OpenLightingProject/ja-rule/boardcfg/README.md

The sub-directories contain the software configuration for each of the
different hardware devices.

The software configuration specifies:
 - which I/O pins to use
 - USB properties, like power consumption
 - Memory organization (for the bootloader).
