OpenLightingProject/ja-rule/hardware/number1/README.md

The hardware design for the Number1 board.
