OpenLightingProject/ja-rule/doxygen/images/transceiver.png

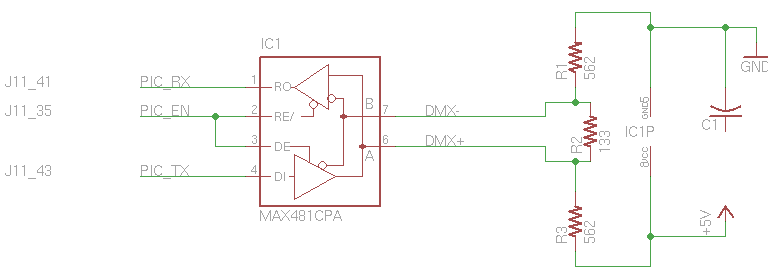
doxygen/images/transceiver.png
