OpenLightingProject/ja-rule/user_manual/README.md

To generate the documentation run

`doxygen`

in this directory. The generated files will be in the *output* directory.
