OpenLightingProject/ja-rule/user_manual/gen/README.md

To re-generate the files in this directory run

$ make doc-gen

from the root ja-rule directory.
