OpenLightingProject/ja-rule/user_manual/docs/examples.md

Examples (remove when complete)
================

[TOC]

# Section 1  {#section1}

First part of updating

## Section 1a  {#section1a}

> Block quote
> Another block quot

# Section 2 {#section2}

1. One
2. Two

# Section 3

This is a *markdown* **file**

 - list one
 - list two

# Section 4

[github]: http://www.example.com "Github"

Code

    this is a block of code
    cont.

end code

`a code span`

# Section 5

---

[github]

# Section 6

First Header  | Second Header
------------- | -------------
Content Cell  | Content Cell
Content Cell  | Content Cell

# Section 7

[back to section 1] (#section1)

# Section 8

I get 10 times more traffic from [Google] than from
[Yahoo] or [MSN].

[google]: http://google.com/        "Google"
[yahoo]:  http://search.yahoo.com/  "Yahoo Search"
[msn]:    http://search.msn.com/    "MSN Search"
