OpenLightingProject/ja-rule/user_manual/images/mac-usb.png

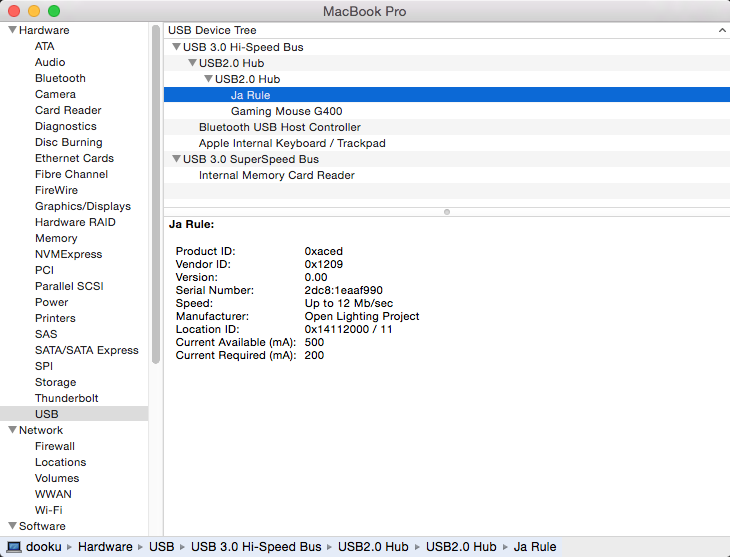
user_manual/images/mac-usb.png
