OpenLightingProject/ja-rule/tests/README.md

# Testing

This directory contains the tests & test infrastructure for the Ja Rule
platform. We use gmock / gtest.

## Directory Layout

**harmony**, The stubbed out harmony API. We stub / mock out all the harmony
calls we make so that we don't have to pull in harmony when running the tests.

**mocks**, The mocks for each module which are used for dependency injection.

**sim**, A basic PIC32 simulator.

**system_config**, The system config header files, including system_config.h &
system_definitions.h

**tests**, The unit tests.
