OpenLightingProject/ja-rule/(threads)

Thread 23 (2015-03-06):

Reset USB CDC transfers when the carrier disconnects

nomis52, 2015-03-06:
Right now, if you have a console  (minicom) open to the device and disconnect the CDC layer is left in a partially completed state.  This means if you later reconnect a console it fails to work.

We can detect the carrier dropping but need a way to cancel the in flight read / write transfers.

nomis52, 2015-03-07:
USB_DEVICE_IRPCancelAll() doesn't work as I expect. There seems to be some internal state that isn't being reset correctly. See the comments on usb_console.c

Thread 25 (2015-03-08):

Add support for adjusting the mark between slot time

nomis52, 2015-03-08:
Right now we send bytes as fast as we can - the mark time between slots is 0.

@nightrune says for crappy fixtures, sometimes you need to increase the time. The standard can go up to 1s (Designation 9, Table 6, E1.11)

Apparently 44uS from end-of-the-second-stop-bit to start-of-the-start-bit is considered 'slow DMX'. That's 88uS byte to byte

nomis52, 2015-03-29:
RDM changes the max time to 2ms. Be careful when implementing this that the max packet time isn't exceeded.

nomis52, 2015-05-16:
See also http://www.etcconnect.com/Support/Articles/DMX-Speed.aspx

Thread 54 (2015-06-14):

Needs to depend on OLA>=0.9.6

peternewman, 2015-06-14:
Doesn't build with OLA 0.9.5 due to this https://github.com/OpenLightingProject/ola/pull/721#issuecomment-111821811

peternewman, 2015-06-14:
g++ -DHAVE_CONFIG_H -I.    -I system_config -I harmony/include -I ../firmware/src -Wall -Wformat -W -Werror -I include -fvisibility-inlines-hidden -isystem ../googlemock-read-only/include -isystem ../googlemock-read-only/gtest/include -I ./mocks -I ./harmony/mocks -pthread   -g -O2 -std=c++11 -MT tests/tests_rdm_responder_test-RDMResponderTest.o -MD -MP -MF tests/.deps/tests_rdm_responder_test-RDMResponderTest.Tpo -c -o tests/tests_rdm_responder_test-RDMResponderTest.o `test -f 'tests/RDMResponderTest.cpp' || echo './'`tests/RDMResponderTest.cpp
tests/RDMResponderTest.cpp: In member function ‘void RDMResponderTest::SendRequest(const ola::rdm::RDMRequest*)’:
tests/RDMResponderTest.cpp:125:5: error: ‘ByteString’ is not a member of ‘ola::io’
tests/RDMResponderTest.cpp:125:25: error: expected ‘;’ before ‘data’
tests/RDMResponderTest.cpp:126:5: error: ‘data’ was not declared in this scope
tests/RDMResponderTest.cpp: In member function ‘virtual void RDMResponderTest_invalidCommand_Test::TestBody()’:
tests/RDMResponderTest.cpp:175:60: error: no matching function for call to ‘ola::rdm::BaseRDMRequest<(ola::rdm::RDMCommand::RDMCommandClass)32u>::BaseRDMRequest(ola::rdm::UID&, ola::rdm::UID&, int, int, int, int, NULL, int)’
tests/RDMResponderTest.cpp:175:60: note: candidate is:
In file included from tests/RDMResponderTest.cpp:24:0:
/usr/include/ola/rdm/RDMCommand.h:350:5: note: ola::rdm::BaseRDMRequest<command_class>::BaseRDMRequest(const ola::rdm::UID&, const ola::rdm::UID&, uint8_t, uint8_t, uint8_t, uint16_t, uint16_t, const uint8_t*, unsigned int) [with ola::rdm::RDMCommand::RDMCommandClass command_class = (ola::rdm::RDMCommand::RDMCommandClass)32u; uint8_t = unsigned char; uint16_t = short unsigned int]
/usr/include/ola/rdm/RDMCommand.h:350:5: note:   candidate expects 9 arguments, 8 provided
tests/RDMResponderTest.cpp: In member function ‘virtual void RDMResponderTest_subdeviceNack_Test::TestBody()’:
tests/RDMResponderTest.cpp:312:69: error: no matching function for call to ‘ola::rdm::BaseRDMRequest<(ola::rdm::RDMCommand::RDMCommandClass)32u>::BaseRDMRequest(ola::rdm::UID&, ola::rdm::UID&, int, int, int, RDMPid, NULL, int)’
tests/RDMResponderTest.cpp:312:69: note: candidate is:
In file included from tests/RDMResponderTest.cpp:24:0:
/usr/include/ola/rdm/RDMCommand.h:350:5: note: ola::rdm::BaseRDMRequest<command_class>::BaseRDMRequest(const ola::rdm::UID&, const ola::rdm::UID&, uint8_t, uint8_t, uint8_t, uint16_t, uint16_t, const uint8_t*, unsigned int) [with ola::rdm::RDMCommand::RDMCommandClass command_class = (ola::rdm::RDMCommand::RDMCommandClass)32u; uint8_t = unsigned char; uint16_t = short unsigned int]
/usr/include/ola/rdm/RDMCommand.h:350:5: note:   candidate expects 9 arguments, 8 provided
tests/RDMResponderTest.cpp: In member function ‘virtual void RDMResponderTest_supportedParameters_Test::TestBody()’:
tests/RDMResponderTest.cpp:335:78: error: no matching function for call to ‘ola::rdm::BaseRDMRequest<(ola::rdm::RDMCommand::RDMCommandClass)32u>::BaseRDMRequest(ola::rdm::UID&, ola::rdm::UID&, int, int, int, RDMPid, NULL, int)’
tests/RDMResponderTest.cpp:335:78: note: candidate is:
In file included from tests/RDMResponderTest.cpp:24:0:
/usr/include/ola/rdm/RDMCommand.h:350:5: note: ola::rdm::BaseRDMRequest<command_class>::BaseRDMRequest(const ola::rdm::UID&, const ola::rdm::UID&, uint8_t, uint8_t, uint8_t, uint16_t, uint16_t, const uint8_t*, unsigned int) [with ola::rdm::RDMCommand::RDMCommandClass command_class = (ola::rdm::RDMCommand::RDMCommandClass)32u; uint8_t = unsigned char; uint16_t = short unsigned int]
/usr/include/ola/rdm/RDMCommand.h:350:5: note:   candidate expects 9 arguments, 8 provided
tests/RDMResponderTest.cpp: In member function ‘virtual void RDMResponderTest_deviceInfo_Test::TestBody()’:
tests/RDMResponderTest.cpp:361:69: error: no matching function for call to ‘ola::rdm::BaseRDMRequest<(ola::rdm::RDMCommand::RDMCommandClass)32u>::BaseRDMRequest(ola::rdm::UID&, ola::rdm::UID&, int, int, int, RDMPid, NULL, int)’
tests/RDMResponderTest.cpp:361:69: note: candidate is:
In file included from tests/RDMResponderTest.cpp:24:0:
/usr/include/ola/rdm/RDMCommand.h:350:5: note: ola::rdm::BaseRDMRequest<command_class>::BaseRDMRequest(const ola::rdm::UID&, const ola::rdm::UID&, uint8_t, uint8_t, uint8_t, uint16_t, uint16_t, const uint8_t*, unsigned int) [with ola::rdm::RDMCommand::RDMCommandClass command_class = (ola::rdm::RDMCommand::RDMCommandClass)32u; uint8_t = unsigned char; uint16_t = short unsigned int]
/usr/include/ola/rdm/RDMCommand.h:350:5: note:   candidate expects 9 arguments, 8 provided
tests/RDMResponderTest.cpp: In member function ‘virtual void RDMResponderTest_deviceModelDescription_Test::TestBody()’:
tests/RDMResponderTest.cpp:386:14: error: no matching function for call to ‘ola::rdm::BaseRDMRequest<(ola::rdm::RDMCommand::RDMCommandClass)32u>::BaseRDMRequest(ola::rdm::UID&, ola::rdm::UID&, int, int, int, RDMPid, NULL, int)’
tests/RDMResponderTest.cpp:386:14: note: candidate is:
In file included from tests/RDMResponderTest.cpp:24:0:
/usr/include/ola/rdm/RDMCommand.h:350:5: note: ola::rdm::BaseRDMRequest<command_class>::BaseRDMRequest(const ola::rdm::UID&, const ola::rdm::UID&, uint8_t, uint8_t, uint8_t, uint16_t, uint16_t, const uint8_t*, unsigned int) [with ola::rdm::RDMCommand::RDMCommandClass command_class = (ola::rdm::RDMCommand::RDMCommandClass)32u; uint8_t = unsigned char; uint16_t = short unsigned int]
/usr/include/ola/rdm/RDMCommand.h:350:5: note:   candidate expects 9 arguments, 8 provided
tests/RDMResponderTest.cpp: In member function ‘virtual void RDMResponderTest_manufacturerLabel_Test::TestBody()’:
tests/RDMResponderTest.cpp:412:14: error: no matching function for call to ‘ola::rdm::BaseRDMRequest<(ola::rdm::RDMCommand::RDMCommandClass)32u>::BaseRDMRequest(ola::rdm::UID&, ola::rdm::UID&, int, int, int, RDMPid, NULL, int)’
tests/RDMResponderTest.cpp:412:14: note: candidate is:
In file included from tests/RDMResponderTest.cpp:24:0:
/usr/include/ola/rdm/RDMCommand.h:350:5: note: ola::rdm::BaseRDMRequest<command_class>::BaseRDMRequest(const ola::rdm::UID&, const ola::rdm::UID&, uint8_t, uint8_t, uint8_t, uint16_t, uint16_t, const uint8_t*, unsigned int) [with ola::rdm::RDMCommand::RDMCommandClass command_class = (ola::rdm::RDMCommand::RDMCommandClass)32u; uint8_t = unsigned char; uint16_t = short unsigned int]
/usr/include/ola/rdm/RDMCommand.h:350:5: note:   candidate expects 9 arguments, 8 provided
tests/RDMResponderTest.cpp: In member function ‘virtual void RDMResponderTest_softwareVersionLabel_Test::TestBody()’:
tests/RDMResponderTest.cpp:436:14: error: no matching function for call to ‘ola::rdm::BaseRDMRequest<(ola::rdm::RDMCommand::RDMCommandClass)32u>::BaseRDMRequest(ola::rdm::UID&, ola::rdm::UID&, int, int, int, RDMPid, NULL, int)’
tests/RDMResponderTest.cpp:436:14: note: candidate is:
In file included from tests/RDMResponderTest.cpp:24:0:
/usr/include/ola/rdm/RDMCommand.h:350:5: note: ola::rdm::BaseRDMRequest<command_class>::BaseRDMRequest(const ola::rdm::UID&, const ola::rdm::UID&, uint8_t, uint8_t, uint8_t, uint16_t, uint16_t, const uint8_t*, unsigned int) [with ola::rdm::RDMCommand::RDMCommandClass command_class = (ola::rdm::RDMCommand::RDMCommandClass)32u; uint8_t = unsigned char; uint16_t = short unsigned int]
/usr/include/ola/rdm/RDMCommand.h:350:5: note:   candidate expects 9 arguments, 8 provided
Makefile:1443: recipe for target 'tests/tests_rdm_responder_test-RDMResponderTest.o' failed
make[1]: *** [tests/tests_rdm_responder_test-RDMResponderTest.o] Error 1

peternewman, 2015-06-14:
I also missed the bigger issue of ByteString!

nomis52, 2015-06-14:
Yup, ByteString is the big one.

peternewman, 2015-06-14:
diff --git a/tests/configure.ac b/tests/configure.ac
index 831fa95..ee2a9a4 100644
--- a/tests/configure.ac
+++ b/tests/configure.ac
@@ -94,7 +94,7 @@ AS_IF([test -z "$PKG_CONFIG"],
 # OLA
 PKG_CHECK_MODULES(
   OLA,
-  [libola],
+  [libola >= 0.9.6],
   [],
   [AC_MSG_ERROR([Missing OLA, please install])])

Closed 2015-06-15.

Thread 99 (2015-07-28):

Add a DMX in mode

nomis52, 2015-07-28:
To receive DMX. This wouldn't have to do anything with RDM.

Thomas-Lettieri-IPS, 2018-10-15:
Is there any status update on this?

peternewman, 2018-10-16:
Hi @Thomas-Lettieri-IPS ,

It still needs doing. No-one is currently working on it if you'd like to have a crack at it?

Thread 152 (2015-09-01):

Number 8 fixes

nomis52, 2015-09-01:
- [x] Hold switch to enter bootloader mode - configure pins correctly
- [x] Figure why the main app won't boot.
- [x] Set the flash write protect bits (and for the SK2 config as well)
- [x] Clean up visual indication of bootloader modes
- [x] Move hardware defines to a config file
- [x] Board specific init (to set pins correctly)

Closed 2015-09-07.

Thread 160 (2015-09-07):

Set the power draw correctly in the USB device descriptor

nomis52, 2015-09-07:
The number8 is drawing 200mA

Closed 2015-09-09.

Thread 168 (2015-09-09):

User Manual Documentation

nomis52, 2015-09-09:
This can be the tracking bug for the user manual. Things we need to cover include:

- [ ] Introduction (move over from the dev manual main page)
- [ ] Accessing the USB console ( move over from dev manual: https://docs.openlighting.org/ja-rule/doc/latest/usb-logging.html )
- [ ] Controller mode
 - [ ] what the LEDs mean
 - [ ] Resistor Biasing
- [ ] Responder mode
 - [ ] What the LEDs mean (mute, identify etc.)
 - [ ] Resistor Biasing
 - [ ] Explanation of each different 'model'. There is existing text in each of the X_model.h files , follow the links from https://docs.openlighting.org/ja-rule/doc/latest/group__rdm__models.html
 - [ ] How to switch between models (move over from dev manual: https://docs.openlighting.org/ja-rule/doc/latest/rdm-models.html )
- [ ] Upgrading the firmware
  - [ ] Linux
  - [ ] Mac (should be similar to Linux)
  - [ ] Windows

peternewman, 2016-02-17:
Some progress in https://github.com/OpenLightingProject/ja-rule/pull/256 .

peternewman, 2016-02-17:
More in https://github.com/OpenLightingProject/ja-rule/pull/259 .

Thread 169 (2015-09-09):

Firmware upgrade for Windows

nomis52, 2015-09-09:
We need to figure out and document how to upgrade the firmware from Windows.

These links may be helpful:

http://wiki.openmoko.org/wiki/Dfu-util-windows
https://github.com/libusb/libusb/wiki/Windows
https://community.particle.io/t/tutorial-installing-dfu-driver-on-windows-24-feb-2015/3518

peternewman, 2015-09-16:
The bottom link works fine on Win 7.

peternewman, 2015-09-16:
Although we then need to work out what interface is what and load some sensible drivers to make them useable.

nomis52, 2015-09-26:
@peternewman do you mean you've actually loaded f/w using the last link?

peternewman, 2015-09-28:
Correct, it throws an error about not being able to disconnect or something, but I only flashed the bootloader via ICSP and did everything else with DFU. I'll do something more serious later like change the device name, just to prove DFU is really working. Also given it's libusb, I think USB on Windows should just work too!

Thread 170 (2015-09-09):

Check why the bootloader alt configs don't show up with labels

nomis52, 2015-09-09:
pi@raspberrypi ~ $ dfu-util -l
dfu-util 0.5

(C) 2005-2008 by Weston Schmidt, Harald Welte and OpenMoko Inc.
(C) 2010-2011 Tormod Volden (DfuSe support)
This program is Free Software and has ABSOLUTELY NO WARRANTY

dfu-util does currently only support DFU version 1.0

Found DFU: [1209:acee] devnum=0, cfg=1, intf=0, alt=0, name="UNDEFINED"
Found DFU: [1209:acee] devnum=0, cfg=1, intf=0, alt=1, name="UNDEFINED"

nomis52, 2015-09-10:
This seems to be an issue with 0.5. 0.8 shows

Found DFU: [1209:acee] ver=0000, devnum=17, cfg=1, intf=0, alt=1, name="UID", serial="7a70:00000003"
Found DFU: [1209:acee] ver=0000, devnum=17, cfg=1, intf=0, alt=0, name="Firmware", serial="7a70:00000003"

Closed 2015-09-10.

Thread 173 (2015-09-10):

Check we handle 0-length frames correctly

nomis52, 2015-09-10:
I have a feeling that sending a break, mark and then no data will lock up the RX state machine. Check if this is the case and fix it.

nomis52, 2015-11-05:
Fixed & tested in #245

Closed 2015-11-05.

Thread 174 (2015-09-10):

Check we can handle long (> 512 bytes) frames

nomis52, 2015-09-10:
This can happen if you unplug and plug the DMX line resulting in concatenating two DMX frames into a much longer one.

Check  this doesn't cause problems with the RX code.

nomis52, 2015-11-05:
I've added tests to cover this.

Closed 2015-11-05.

Thread 177 (2015-09-14):

Switch to the latest GMock

peternewman, 2015-09-14:
Moved from GoogleCode to: https://github.com/google/googlemock

Which has now moved to part of GoogleTest:
https://github.com/google/googletest

nomis52, 2015-09-17:
Blocked behind some fixes on the gmock side:

https://github.com/google/googletest/issues/588

Closed 2015-09-18.

Thread 181 (2015-09-16):

hex2dfu doesn't handle DOS output with carriage returns

peternewman, 2015-09-16:
I can fix the first error:
tools/hex2dfu firmware/ja-rule.X/dist/number8/production/ja-rule.X.production.hex
Missing \n on line 1
337885 bytes remain in hex file

With:
diff --git a/tools/hex2dfu.c b/tools/hex2dfu.c
index b1aee72..a624b6f 100644
--- a/tools/hex2dfu.c
+++ b/tools/hex2dfu.c
@@ -248,8 +248,8 @@ void ProcessHexFile(int fd, const Options *options) {
       return;
     }

-    if (checksum_data[2] != '\n') {
-      printf("Missing \\n on line %d\n", line);
+    if (checksum_data[2] != '\n' && checksum_data[2] != '\r') {
+      printf("Missing \\n or \\r on line %d\n", line);
       return;
     }

But then it throws:
tools/hex2dfu firmware/ja-rule.X/dist/number8/production/ja-rule.X.production.hex
Invalid start code '
' on line 2
337876 bytes remain in hex file

I don't know how we want to go about fixing this?

nomis52, 2015-09-17:
Oh interesting. It sounds like the compiler on windows produces hex files with dos line endings?

Can you send me the hex file and I'll sort out a patch.

peternewman, 2015-09-17:
Yep,  exactly that. I just converted them from DOS back to Unix, so you should be able to revert that to test.

I'm quite happy to give it a go. I guess we just need to seek on an extra character at the end of each line?

nomis52, 2015-09-17:
Yeah, you need to scan forward until something other than a \n or \r is found.

I'd change

    // read the checksum & new line
    char checksum_data[3];

to

    // read the checksum & new line
    char checksum_data[2];

and then change

    if (checksum_data[2] != '\n') {

to a while loop.

Closed 2015-09-26.

Thread 183 (2015-09-17):

Ja Rule CDC Serial doesn't show up on OS X 10.6.8

peternewman, 2015-09-17:
(15:06:56) PeterNewman4: ah, from Kernel.log
(15:07:02) PeterNewman4: Sep 17 15:04:58 MacMini-Control kernel[0]: 0        0 AppleUSBCDCACMControl: start - Failed to find the CDC driver
(15:07:06) PeterNewman4: Sep 17 15:05:03 MacMini-Control kernel[0]:    0        1 AppleUSBCDCACMData: start - Find CDC driver for data interface failed
(15:07:53) nomis52: ah ha
(15:11:33) PeterNewman4: the bottom of this seems relevant
(15:12:03) PeterNewman4: http://forum.espruino.com/conversations/266748/ even
(15:12:56) nomis52: http://forum.micropython.org/viewtopic.php?t=157
(15:14:11) PeterNewman4: https://github.com/espruino/Espruino/commit/8b8bae7ba1e943c5113fc82f922830e21f3a3b2d
(15:14:20) nomis52: yup
(15:14:27) nomis52: that's what the micropython post says
(15:15:58) PeterNewman4: k
(15:17:38) nomis52: so we're already set to 0x02
(15:17:49) nomis52: but let me check capabilties
(15:18:48) nomis52: ok
(15:18:51) nomis52: usb_descriptors.c
(15:18:53) nomis52: line 138
(15:18:59) nomis52: try changing to 0x03

nomis52, 2015-09-24:
I tested Ja Rule on 10.5.7 and it works apart from the CDC serial console. According to http://lists.apple.com/archives/usb/2010/Nov/msg00040.html composite CDC devices are only supported in 10.7+

I'll leave this open until we can confirm 10.7 works and then update the docs (somewhere!).

peternewman, 2015-09-26:
Confirmed working on 10.7.5

Closed 2015-09-26.

Thread 201 (2015-10-01):

Qualify the 2nd port on the Number1 device.

nomis52, 2015-10-01:
We need to make sure this is good electrically.

nomis52, 2015-10-03:
Done. I ended up bridging pins 44,45& 46:

ECOL/AECRSDV/SCL1/IC3/PMCS2/PMA15/INT3/RD10 (44)
ECRS/AEREFCLK/IC4/PMCS1/PMA14/INT4/RD11 (45)
OC1/INT0/RD0 (46)

Recall the first gen #1 had a h/w bug where the RX line was connected to 46 rather than one of the IC pins.

The following is sufficient to get it working using IC3

  PLIB_OC_Disable(OC_ID_1);
  PLIB_PORTS_PinDirectionInputSet(PORTS_ID_0, PORT_CHANNEL_D, PORTS_BIT_POS_0);
  PLIB_PORTS_PinDirectionInputSet(PORTS_ID_0, PORT_CHANNEL_D, PORTS_BIT_POS_10);
  PLIB_PORTS_PinDirectionInputSet(PORTS_ID_0, PORT_CHANNEL_D, PORTS_BIT_POS_11);
  PLIB_PMP_Disable(PMP_ID_0);
  PLIB_I2C_Disable(I2C_ID_1);
  PLIB_ETH_Disable(ETH_ID_0);

peternewman, 2015-10-03:
Was this tested at the same time as port 1 being in use?

nomis52, 2015-10-03:
No, we need more extensive code changes for that. This was just making sure the h/w design was ok.

Closed 2015-10-03.

Thread 205 (2015-10-03):

Defend against abnormal events

nomis52, 2015-10-03:
One thing I found during testing today, if you disconnect the IC line, the unit 'locks up' when used as an RDM controller with one or more responders on the line. This is because without IC we never enter the STATE_C_RX_IN_DUB but the UART is still receiving and Transceiver_UARTEvent() is called repeatably.

This is symptomatic of a general class of 'abnormal' failures. If something happens that we don't expect, we should enter the ERROR state and reset the unit.

e.g.

    case STATE_C_INITIALIZE:
    case STATE_C_TX_READY:
    case STATE_C_TX_DATA:
    case STATE_C_TX_DRAIN:
    case STATE_C_RX_WAIT_FOR_BREAK:
    case STATE_C_RX_WAIT_FOR_MARK:
    case STATE_C_RX_DATA:
    case STATE_C_RX_WAIT_FOR_DUB:
    case STATE_C_RX_IN_DUB:
    case STATE_C_RX_TIMEOUT:
    case STATE_C_COMPLETE:
    case STATE_C_BACKOFF:
    case STATE_R_INITIALIZE:
    case STATE_R_RX_PREPARE:
    case STATE_R_RX_BREAK:
    case STATE_R_RX_MARK:
    case STATE_R_RX_MBB:
    case STATE_R_RX_DATA:
    case STATE_R_TX_DATA:
    case STATE_R_TX_DRAIN:
    case STATE_R_TX_COMPLETE:
    case STATE_ERROR:
    case STATE_RESET:
      // Should never happen
      {}

That last line should handle the failure.

Bartel-C8, 2023-03-10:
@peternewman : Do you have the OLA RDM test suite still running?

Is there any Ja-Rule board we can order somehow, alternatively, if the reference design is not supported?

peternewman, 2023-03-13:
> @peternewman : Do you have the OLA RDM test suite still running?

Yeah, I ran some through a Number 1 at the recent Lille Plugfest seemingly without issues (aside from with the device under test). Is that what you meant?

> Is there any Ja-Rule board we can order somehow, alternatively, if the reference design is not supported?

The company that made the original batch of Number 1's aren't doing so anymore unfortunately. The design is here, but I'm not sure if it includes a PCB layout:
https://github.com/OpenLightingProject/ja-rule/tree/master/hardware/number1

Bartel-C8, 2023-03-22:
@peternewman , thanks for your reply. We've met actually in Lille ;-), I was the one of Constell8/KLSTR.

The hardware schematics are there of the Number1. But we bought the development kit of Microchip, which the Number1 was based upon. But can't get it working with that...

Thread 211 (2015-10-08):

Write a small tool to extract the MAC & UID from devices

nomis52, 2015-10-08:
This will help @mrpackethead

peternewman, 2015-10-08:
Is this a standalone tool? Is it designed to be run once OLE is already installed on the device?

mrpackethead, 2015-10-08:

It will be a factory tool, to grab UID / Serial etc etc, and keep it tracked. as well as run some diagnostics.

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

peternewman, 2015-10-09:
So the OLE firmware will be flashed onto the device already? It's not alternative firmware to just do that job?

Can we just build it as part of the OLA Ja Rule tools, or does it need to be standalone?

mrpackethead, 2015-10-09:
There's two parts I guess. One is some extra functionality in OLE to respond to some factory commands via USB.   The other part will be a small utility running on a beagle bone that will run the tests grab the UID and log it etc

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

peternewman, 2015-10-09:
That all makes sense. The UID bit is in OLE already, and extending one of the existing OLA tools to report it directly and then exit should be fine. Adding the MAC just needs a little bit more work. What's the serial? Is that different to the UID?

nomis52, 2015-10-09:
serial = UID.

The short list of work is:
 - add a new command  type to dump the MAC, return 0 if there isn't a MAC address
 - add a tool to print the UID & MAC of any connected ja-rule devices.

peternewman, 2015-10-10:
We should add the Ja Rule model ID to that list too (i.e. if it's a no. 1, no. 8 etc)

nomis52, 2015-10-12:
I reworked the GET_UID command to now return the model id, the UID and the MAC address.

I still need to work on the host side tool.

nomis52, 2015-10-16:
This is done

mrpackethead, 2015-10-16:
oh really?

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

peternewman, 2015-10-20:
Do we not want something that doesn't require user interaction? It looks like the current tool makes you press comma after plugging in each Number1?

mrpackethead, 2015-10-21:
Ultimately it would be good to be abel to do some more thins in the back
ground.. Record the info to a database, and also print some labels.. But
that doesn't have to happen today.

On Wed, Oct 21, 2015 at 12:29 PM, Peter Newman <notifications@github.com>
wrote:

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

Closed 2015-10-16.

Thread 226 (2015-10-12):

Add code to differentiate the single and dual port Number1

nomis52, 2015-10-12:
As discussed with @mrpackethead , we'll short the UART TX / RX pins of the 2nd UART if the board is a single port option. This will allow us to only expose a single port to OLA.

Thread 228 (2015-10-12):

proxy device model fails some RDM tests

nomis52, 2015-10-12:
DUBSingleUpperUID
DUBNegativeLowerBound: Failed

I suspect we're not tracking the mute state on a per-child basis.

nomis52, 2015-11-07:
This isn't a bug in the responder. Instead in the RDM REsponder tests we assume all devices are muted before starting. I'll send a fix.

nomis52, 2015-11-08:
Confirmed fixed with PR 970 in the OLA repo

peternewman, 2015-11-08:
AKA https://github.com/OpenLightingProject/ola/pull/970 .

Closed 2015-11-08.

Thread 230 (2015-10-12):

Calibrate the temp sensor

nomis52, 2015-10-12:
We should run the internal calibration sequence.

peternewman, 2015-10-20:
Can't this be closed via https://github.com/OpenLightingProject/ja-rule/pull/234 now @nomis52 ?

nomis52, 2015-10-21:
Yup

Closed 2015-10-21.

Thread 231 (2015-10-12):

Add a 'self test' command to check the USART is wired correctly

nomis52, 2015-10-12:

nomis52, 2015-10-15:
This is complete now.

Closed 2015-10-15.

Thread 236 (2015-10-24):

Current HEAD breaks RX

nomis52, 2015-10-24:
The addition of the self test command broke RX support. I need to fix this.

nomis52, 2015-11-05:
This was fixed.

Closed 2015-11-05.

Thread 250 (2015-11-11):

Get Windows USB working

nomis52, 2015-11-11:
http://msdn.microsoft.com/en-us/library/windows/hardware/hh450799.aspx http://msdn.microsoft.com/en-us/library/windows/hardware/ff537430.aspx
http://msdn.microsoft.com/en-us/windows/hardware/gg463179 http://blogs.msdn.com/b/usbcoreblog/archive/2009/10/31/how-does-usb-stack-enumerate-a-device.aspx

Notes from IRC:

- make sure to implement the device according to the MSFT spec they call "WinUSB Device"
-  it requires one string descriptor with a binary structure MSFT calls "Microsoft OS Descriptor" or MOD, along with one control request to pass back another data structure described by them
- Is this similar to what FadeCandy has?   yes, but don't spread the WCID disease  . That's a made-up term for the MSFT concept used with WinUSB Device

nightrune, 2016-03-04:
Is this in reference to the Number 1 side or the OLA driver side?

nomis52, 2016-03-05:
The Number1 side

Thread 265 (2016-04-21):

Schematic doesn't show ribbon connector on it

peternewman, 2016-04-21:
