OpenLightingProject/ja-rule/hardware/number1/schematic.pdf

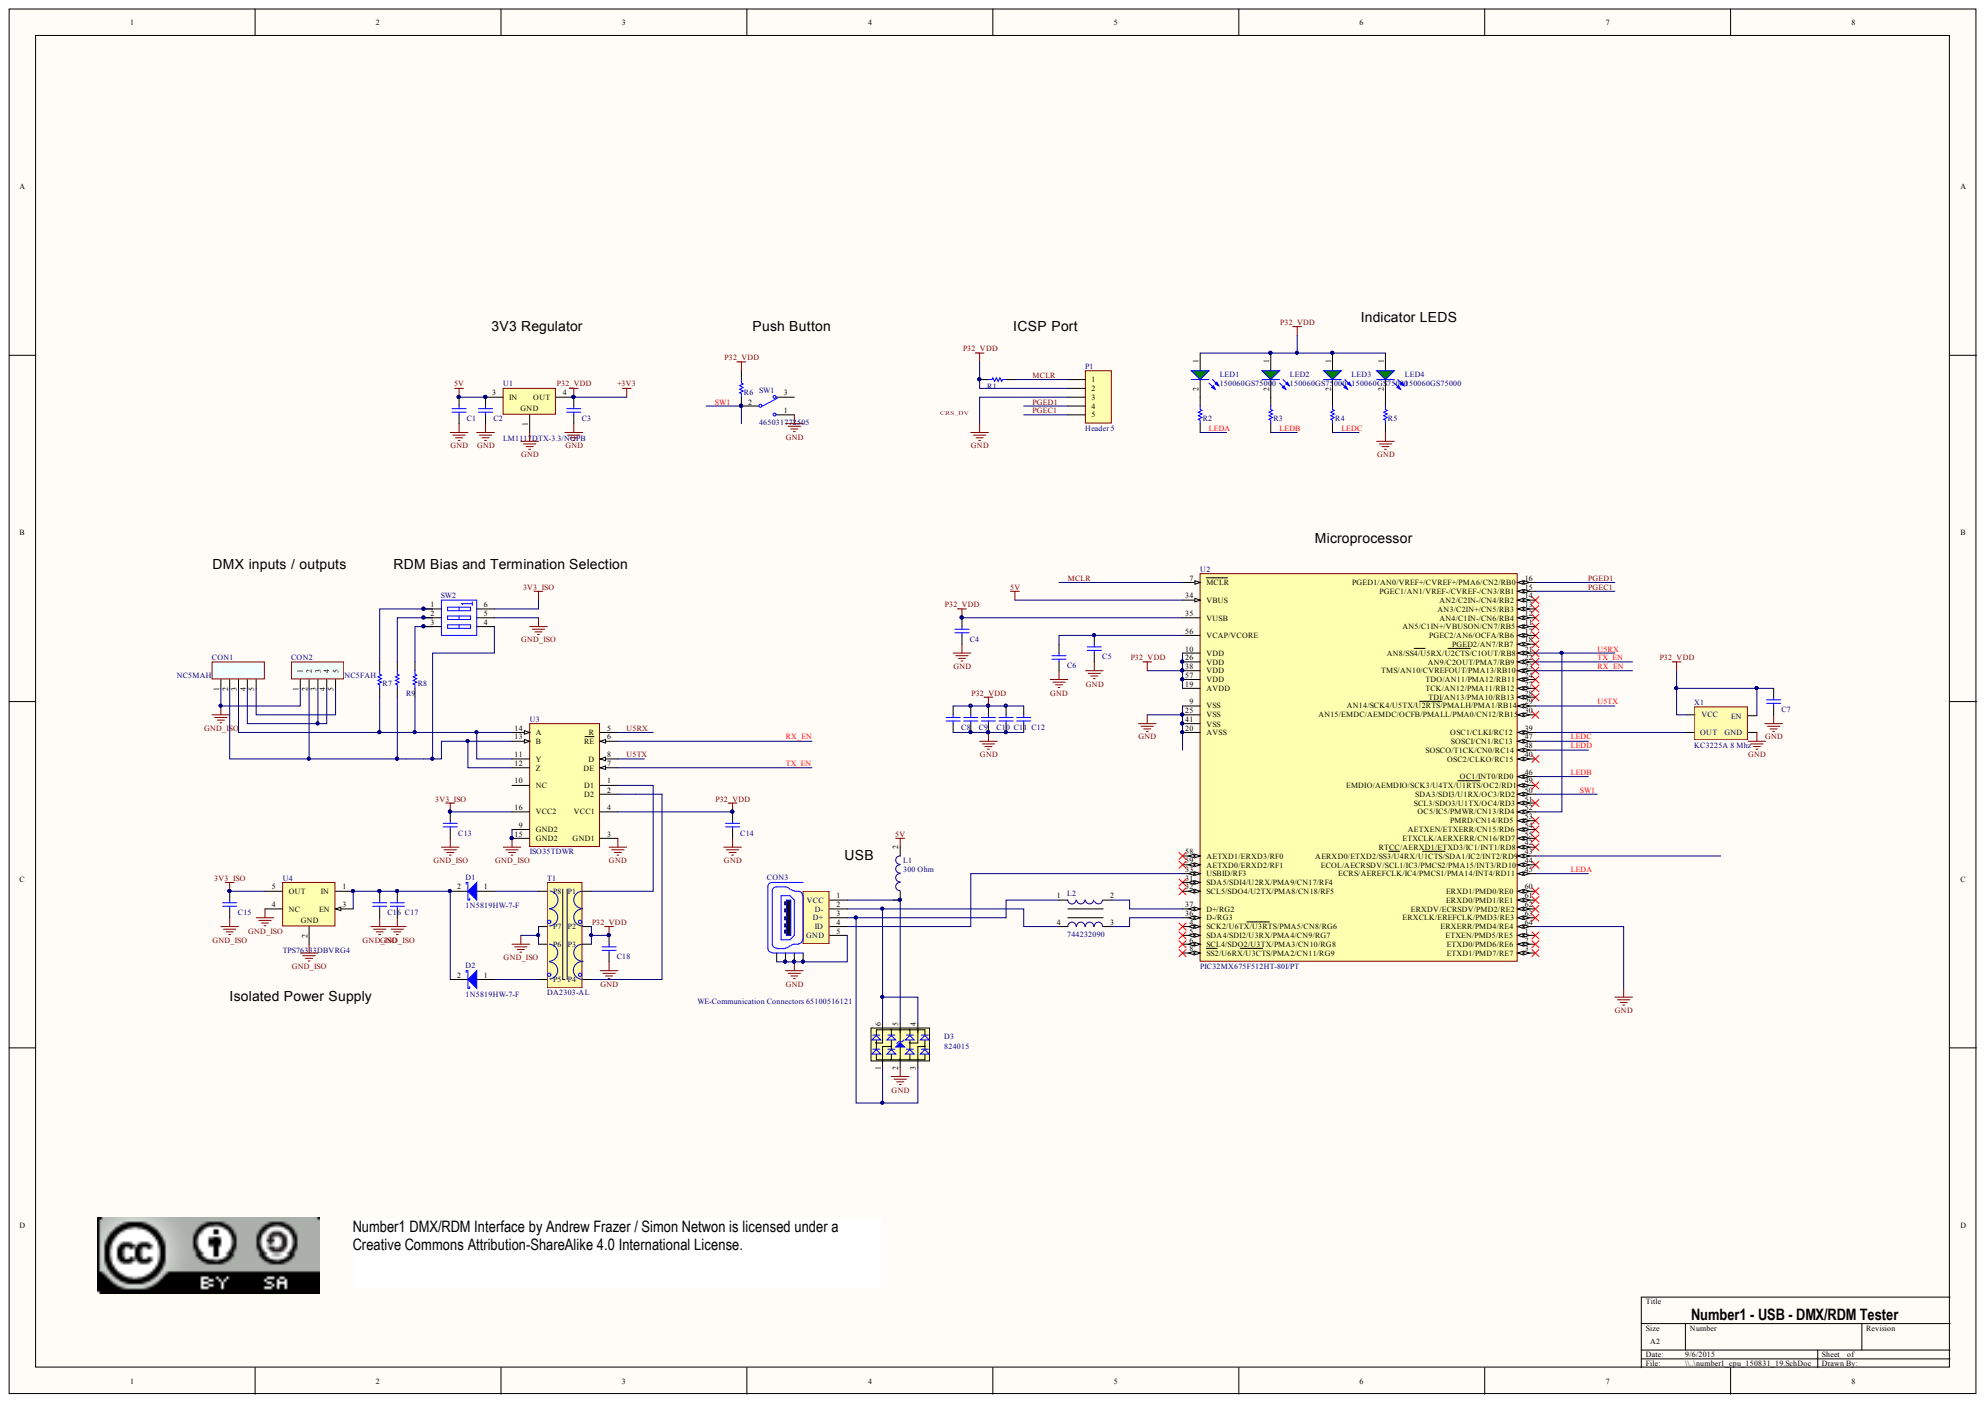
[picture p3: page 1]

Number1 DMX/RDM Interface by Andrew Frazer / Simon Netwon is licensed under a
Creative Commons Attribution-ShareAlike 4.0 International License.

Title
Number1 - USB - DMX/RDM Tester
