OpenLightingProject/ja-rule/(list of files, drawings)

Other design files:
hardware/number1/number1.SchDoc
