OpenLightingProject/ja-rule/firmware/src/moving_light.c

/*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
 * moving_light.c
 * Copyright (C) 2015 Simon Newton
 */
#include "moving_light.h"

#include <stdlib.h>

#include "coarse_timer.h"
#include "constants.h"
#include "macros.h"
#include "rdm_buffer.h"
#include "rdm_frame.h"
#include "rdm_responder.h"
#include "rdm_util.h"
#include "utils.h"

// Various constants
enum { SOFTWARE_VERSION = 0x00000000 };
enum { PERSONALITY_COUNT = 2 };
enum { NUMBER_OF_LANGUAGES = 2 };

static const unsigned int LAMP_STRIKE_DELAY = 50000u;
static const uint32_t ONE_SECOND = 10000;
static const char DEVICE_MODEL_DESCRIPTION[] = "Ja Rule Moving Light";
static const char SOFTWARE_LABEL[] = "Alpha";
static const char DEFAULT_DEVICE_LABEL[] = "Default Label";
static const char PERSONALITY_DESCRIPTION1[] = "8-bit mode";
static const char PERSONALITY_DESCRIPTION2[] = "16-bit mode";

static const char LANGUAGE_ENGLISH[] = "en";
static const char LANGUAGE_FRENCH[] = "fr";

static const ResponderDefinition RESPONDER_DEFINITION;

/*
 * @brief The simple model state.
 */
typedef struct {
  uint32_t device_hours;
  uint32_t lamp_hours;
  uint32_t lamp_strikes;
  uint32_t device_power_cycles;
  CoarseTimer_Value lamp_strike_time;
  CoarseTimer_Value clock_timer;
  uint8_t lamp_state;
  uint8_t lamp_on_mode;
  uint8_t display_level;
  uint8_t display_invert;
  uint8_t power_state;
  uint8_t language_index;
  bool pan_invert;
  bool tilt_invert;
  bool pan_tilt_swap;
  bool using_factory_defaults;

  // The Clock
  uint16_t year;
  uint8_t month;
  uint8_t day;
  uint8_t hour;
  uint8_t minute;
  uint8_t second;
} MovingLightModel;

static const char *LANGUAGES[NUMBER_OF_LANGUAGES] = {
  LANGUAGE_ENGLISH,
  LANGUAGE_FRENCH,
};

static MovingLightModel g_moving_light;

// Helper functions
// ----------------------------------------------------------------------------
static void MovingLightModel_ResetToFactoryDefaults() {
  g_moving_light.lamp_state = LAMP_OFF;
  g_moving_light.lamp_on_mode = LAMP_ON_MODE_ON;
  g_moving_light.display_level = 255u;
  g_moving_light.display_invert = false;
  g_moving_light.power_state = POWER_STATE_NORMAL;
  g_moving_light.pan_invert = false;
  g_moving_light.tilt_invert = false;
  g_moving_light.pan_tilt_swap = false;
  g_moving_light.using_factory_defaults = true;
}

uint8_t DaysInMonth(uint16_t year, uint8_t month) {
  bool is_leap_year = false;
  if (year % 4u == 0u) {
    if (year % 100u) {
      is_leap_year = (year % 400 == 0u);
    } else {
      is_leap_year = true;
    }
  }

  switch (month) {
    case 1:
    case 3:
    case 5:
    case 7:
    case 8:
    case 10:
    case 12:
      return 31;
      break;
    case 2:
      return is_leap_year ? 29 :28;
      break;
    case 4:
    case 6:
    case 9:
    case 11:
      return 30;
      break;
    default:
      return 0;
  }
}

// PID Handlers
// ----------------------------------------------------------------------------
int MovingLightModel_GetLanguageCapabilities(const RDMHeader *header,
                                            UNUSED const uint8_t *param_data) {
  uint8_t *ptr = g_rdm_buffer + sizeof(RDMHeader);
  unsigned int i = 0;
  for (; i < NUMBER_OF_LANGUAGES; i++) {
    ptr += RDMUtil_StringCopy((char*) ptr, RDM_LANGUAGE_STRING_SIZE,
                              LANGUAGES[i], RDM_LANGUAGE_STRING_SIZE);
  }
  return RDMResponder_AddHeaderAndChecksum(header, ACK, ptr - g_rdm_buffer);
}

int MovingLightModel_GetLanguage(const RDMHeader *header,
                                 UNUSED const uint8_t *param_data) {
  uint8_t *ptr = g_rdm_buffer + sizeof(RDMHeader);
  ptr += RDMUtil_StringCopy((char*) ptr, RDM_LANGUAGE_STRING_SIZE,
                            LANGUAGES[g_moving_light.language_index],
                            RDM_LANGUAGE_STRING_SIZE);
  return RDMResponder_AddHeaderAndChecksum(header, ACK, ptr - g_rdm_buffer);
}

int MovingLightModel_SetLanguage(const RDMHeader *header,
                                 const uint8_t *param_data) {
  if (header->param_data_length != RDM_LANGUAGE_STRING_SIZE) {
    return RDMResponder_BuildNack(header, NR_FORMAT_ERROR);
  }
  const char *new_lang = (const char*) param_data;

  bool matched = false;
  unsigned int i = 0;
  for (; i < NUMBER_OF_LANGUAGES; i++) {
    if (memcmp(LANGUAGES[i], new_lang, RDM_LANGUAGE_STRING_SIZE) == 0) {
      g_moving_light.language_index = i;
      matched = true;
      break;
    }
  }

  if (!matched) {
    return RDMResponder_BuildNack(header, NR_DATA_OUT_OF_RANGE);
  }
  return RDMResponder_BuildSetAck(header);
}

int MovingLightModel_GetBool(const RDMHeader *header,
                             UNUSED const uint8_t *param_data) {
  switch (ntohs(header->param_id)) {
    case PID_PAN_INVERT:
      return RDMResponder_GenericGetBool(header, g_moving_light.pan_invert);
    case PID_TILT_INVERT:
      return RDMResponder_GenericGetBool(header, g_moving_light.tilt_invert);
    case PID_PAN_TILT_SWAP:
      return RDMResponder_GenericGetBool(header, g_moving_light.pan_tilt_swap);
    default:
      return RDM_RESPONDER_NO_RESPONSE;
  }
}

int MovingLightModel_SetBool(const RDMHeader *header,
                             const uint8_t *param_data) {
  bool *value = NULL;
  switch (ntohs(header->param_id)) {
    case PID_PAN_INVERT:
      value = &g_moving_light.pan_invert;
      break;
    case PID_TILT_INVERT:
      value = &g_moving_light.tilt_invert;
      break;
    case PID_PAN_TILT_SWAP:
      value = &g_moving_light.pan_tilt_swap;
      break;
    default:
      return RDM_RESPONDER_NO_RESPONSE;
  }

  bool old_value = *value;
  int response_size = RDMResponder_GenericSetBool(header, param_data, value);
  if (*value != old_value) {
    g_moving_light.using_factory_defaults = false;
  }
  return response_size;
}

int MovingLightModel_GetUInt8(const RDMHeader *header,
                              UNUSED const uint8_t *param_data) {
  switch (ntohs(header->param_id)) {
    case PID_LAMP_STATE:
      return RDMResponder_GenericGetUInt8(header, g_moving_light.lamp_state);
    case PID_LAMP_ON_MODE:
      return RDMResponder_GenericGetUInt8(header, g_moving_light.lamp_on_mode);
    case PID_DISPLAY_INVERT:
      return RDMResponder_GenericGetUInt8(header,
                                          g_moving_light.display_invert);
    case PID_DISPLAY_LEVEL:
      return RDMResponder_GenericGetUInt8(header, g_moving_light.display_level);
    case PID_POWER_STATE:
      return RDMResponder_GenericGetUInt8(header, g_moving_light.power_state);
    default:
      return RDM_RESPONDER_NO_RESPONSE;
  }
}

int MovingLightModel_SetUInt8(const RDMHeader *header,
                              const uint8_t *param_data) {
  if (ntohs(header->param_id) != PID_DISPLAY_LEVEL) {
    return RDM_RESPONDER_NO_RESPONSE;
  }
  uint8_t old_value = g_moving_light.display_level;
  int response_size = RDMResponder_GenericSetUInt8(
      header, param_data, &g_moving_light.display_level);
  if (g_moving_light.display_level != old_value) {
    g_moving_light.using_factory_defaults = false;
  }
  return response_size;
}

int MovingLightModel_GetUInt32(const RDMHeader *header,
                               UNUSED const uint8_t *param_data) {
  switch (ntohs(header->param_id)) {
    case PID_DEVICE_HOURS:
      return RDMResponder_GenericGetUInt32(header, g_moving_light.device_hours);
    case PID_LAMP_HOURS:
      return RDMResponder_GenericGetUInt32(header, g_moving_light.lamp_hours);
    case PID_LAMP_STRIKES:
      return RDMResponder_GenericGetUInt32(header, g_moving_light.lamp_strikes);
    case PID_DEVICE_POWER_CYCLES:
      return RDMResponder_GenericGetUInt32(
          header, g_moving_light.device_power_cycles);
    default:
      return RDM_RESPONDER_NO_RESPONSE;
  }
}

int MovingLightModel_SetUInt32(const RDMHeader *header,
                               const uint8_t *param_data) {
  switch (ntohs(header->param_id)) {
    case PID_DEVICE_HOURS:
      return RDMResponder_GenericSetUInt32(header, param_data,
                                           &g_moving_light.device_hours);
    case PID_LAMP_HOURS:
      return RDMResponder_GenericSetUInt32(header, param_data,
                                           &g_moving_light.lamp_hours);
    case PID_LAMP_STRIKES:
      return RDMResponder_GenericSetUInt32(header, param_data,
                                           &g_moving_light.lamp_strikes);
    case PID_DEVICE_POWER_CYCLES:
      return RDMResponder_GenericSetUInt32(header, param_data,
                                           &g_moving_light.device_power_cycles);
    default:
      return RDM_RESPONDER_NO_RESPONSE;
  }
}

int MovingLightModel_GetFactoryDefaults(const RDMHeader *header,
                                        UNUSED const uint8_t *param_data) {
  bool using_defaults = (g_moving_light.using_factory_defaults &&
                         g_responder->using_factory_defaults);
  return RDMResponder_GenericGetBool(header, using_defaults);
}

int MovingLightModel_SetFactoryDefaults(const RDMHeader *header,
                                        UNUSED const uint8_t *param_data) {
  if (header->param_data_length != 0u) {
    return RDMResponder_BuildNack(header, NR_FORMAT_ERROR);
  }

  MovingLightModel_ResetToFactoryDefaults();
  RDMResponder_ResetToFactoryDefaults();
  return RDMResponder_BuildSetAck(header);
}

int MovingLightModel_SetLampState(const RDMHeader *header,
                                  const uint8_t *param_data) {
  if (header->param_data_length != sizeof(uint8_t)) {
    return RDMResponder_BuildNack(header, NR_FORMAT_ERROR);
  }

  if (param_data[0] > LAMP_STRIKE) {
    return RDMResponder_BuildNack(header, NR_DATA_OUT_OF_RANGE);
  }
  if (g_moving_light.lamp_state == LAMP_OFF && param_data[0] == LAMP_ON) {
    g_moving_light.lamp_strikes++;
  }
  if (g_moving_light.lamp_state != param_data[0]) {
    g_moving_light.using_factory_defaults = false;
  }
  g_moving_light.lamp_state = param_data[0];
  if (g_moving_light.lamp_state == LAMP_STRIKE) {
    g_moving_light.lamp_strike_time = CoarseTimer_GetTime();
  }
  return RDMResponder_BuildSetAck(header);
}

int MovingLightModel_SetLampOnMode(const RDMHeader *header,
                                   const uint8_t *param_data) {
  if (header->param_data_length != sizeof(uint8_t)) {
    return RDMResponder_BuildNack(header, NR_FORMAT_ERROR);
  }

  if (param_data[0] > LAMP_ON_MODE_ON_AFTER_CAL) {
    return RDMResponder_BuildNack(header, NR_DATA_OUT_OF_RANGE);
  }
  if (g_moving_light.lamp_on_mode != param_data[0]) {
    g_moving_light.using_factory_defaults = false;
  }
  g_moving_light.lamp_on_mode = param_data[0];
  return RDMResponder_BuildSetAck(header);
}

int MovingLightModel_SetDisplayInvert(const RDMHeader *header,
                                      const uint8_t *param_data) {
  if (header->param_data_length != sizeof(uint8_t)) {
    return RDMResponder_BuildNack(header, NR_FORMAT_ERROR);
  }

  if (param_data[0] > DISPLAY_INVERT_AUTO) {
    return RDMResponder_BuildNack(header, NR_DATA_OUT_OF_RANGE);
  }
  if (g_moving_light.display_invert != param_data[0]) {
    g_moving_light.using_factory_defaults = false;
  }
  g_moving_light.display_invert = param_data[0];
  return RDMResponder_BuildSetAck(header);
}

int MovingLightModel_SetPowerState(const RDMHeader *header,
                                   const uint8_t *param_data) {
  if (header->param_data_length != sizeof(uint8_t)) {
    return RDMResponder_BuildNack(header, NR_FORMAT_ERROR);
  }

  if (param_data[0] > POWER_STATE_STANDBY &&
      param_data[0] != POWER_STATE_NORMAL) {
    return RDMResponder_BuildNack(header, NR_DATA_OUT_OF_RANGE);
  }
  if (g_moving_light.power_state != param_data[0]) {
    g_moving_light.using_factory_defaults = false;
  }
  g_moving_light.power_state = param_data[0];
  return RDMResponder_BuildSetAck(header);
}

int MovingLightModel_GetClock(const RDMHeader *header,
                              UNUSED const uint8_t *param_data) {
  uint8_t *ptr = g_rdm_buffer + sizeof(RDMHeader);
  ptr = PushUInt16(ptr, g_moving_light.year);
  *ptr++ = g_moving_light.month;
  *ptr++ = g_moving_light.day;
  *ptr++ = g_moving_light.hour;
  *ptr++ = g_moving_light.minute;
  *ptr++ = g_moving_light.second;
  return RDMResponder_AddHeaderAndChecksum(header, ACK, ptr - g_rdm_buffer);
}

int MovingLightModel_SetClock(const RDMHeader *header,
                              const uint8_t *param_data) {
  if (header->param_data_length != sizeof(uint16_t) + 5 * sizeof(uint8_t)) {
    return RDMResponder_BuildNack(header, NR_FORMAT_ERROR);
  }

  const uint16_t year = ExtractUInt16(param_data);
  const uint8_t month = param_data[2];
  if (year < 2003u || month == 0u || month > 12u) {
    return RDMResponder_BuildNack(header, NR_DATA_OUT_OF_RANGE);
  }

  const uint8_t day = param_data[3];
  const uint8_t hour = param_data[4];
  const uint8_t minute = param_data[5];
  const uint8_t second = param_data[6];

  // We don't support leap seconds for now.
  if (day == 0u || day > DaysInMonth(year, month) || hour > 24u ||
      minute > 59u || second > 59u) {
    return RDMResponder_BuildNack(header, NR_DATA_OUT_OF_RANGE);
  }

  g_moving_light.year = year;
  g_moving_light.month = month;
  g_moving_light.day = day;
  g_moving_light.hour = hour;
  g_moving_light.minute = minute;
  g_moving_light.second = second;
  return RDMResponder_BuildSetAck(header);
}

int MovingLightModel_ResetDevice(const RDMHeader *header,
                                 const uint8_t *param_data) {
  if (header->param_data_length != sizeof(uint8_t)) {
    return RDMResponder_BuildNack(header, NR_FORMAT_ERROR);
  }

  if (param_data[0] != 0x01) {
    return RDMResponder_BuildNack(header, NR_DATA_OUT_OF_RANGE);
  }

  // warm reset
  g_responder->is_muted = false;
  return RDMResponder_BuildSetAck(header);
}

// Public Functions
// ----------------------------------------------------------------------------
void MovingLightModel_Initialize() {
  MovingLightModel_ResetToFactoryDefaults();
  g_moving_light.lamp_state = LAMP_OFF;
  g_moving_light.lamp_on_mode = LAMP_ON_MODE_ON;
  g_moving_light.display_level = 255u;
  g_moving_light.display_invert = false;
  g_moving_light.power_state = POWER_STATE_NORMAL;
  g_moving_light.pan_invert = false;
  g_moving_light.tilt_invert = false;
  g_moving_light.pan_tilt_swap = false;
  g_moving_light.language_index = 0;

  g_moving_light.year = 2003u;
  g_moving_light.month = 1u;
  g_moving_light.day = 1u;
  g_moving_light.hour = 0u;
  g_moving_light.minute = 0u;
  g_moving_light.second = 0u;
}

static void MovingLightModel_Activate() {
  g_responder->def = &RESPONDER_DEFINITION;
  RDMResponder_InitResponder();
  g_moving_light.clock_timer = CoarseTimer_GetTime();
}

static void MovingLightModel_Deactivate() {
}

static int MovingLightModel_HandleRequest(const RDMHeader *header,
                                          const uint8_t *param_data) {
  if (!RDMUtil_RequiresAction(g_responder->uid, header->dest_uid)) {
    return RDM_RESPONDER_NO_RESPONSE;
  }

  if (header->command_class == DISCOVERY_COMMAND) {
    return RDMResponder_HandleDiscovery(header, param_data);
  }

  uint16_t sub_device = ntohs(header->sub_device);

  // No subdevices.
  if (sub_device != SUBDEVICE_ROOT && sub_device != SUBDEVICE_ALL) {
    return RDMResponder_BuildNack(header, NR_SUB_DEVICE_OUT_OF_RANGE);
  }

  // This model has no sub devices.
  if (header->command_class == GET_COMMAND && sub_device == SUBDEVICE_ALL) {
    return RDMResponder_BuildNack(header, NR_SUB_DEVICE_OUT_OF_RANGE);
  }

  return RDMResponder_DispatchPID(header, param_data);
}

static void MovingLightModel_Tasks() {
  if (g_moving_light.lamp_state == LAMP_STRIKE &&
      CoarseTimer_HasElapsed(g_moving_light.lamp_strike_time,
                             LAMP_STRIKE_DELAY)) {
    g_moving_light.lamp_state = LAMP_ON;
    g_moving_light.lamp_strikes++;
  }

  if (CoarseTimer_HasElapsed(g_moving_light.clock_timer, ONE_SECOND)) {
    g_moving_light.clock_timer = CoarseTimer_GetTime();
    g_moving_light.second++;
    if (g_moving_light.second >= 60u) {
      g_moving_light.second = 0u;
      g_moving_light.minute++;
    }
    if (g_moving_light.minute >= 60u) {
      g_moving_light.minute = 0u;
      g_moving_light.hour++;
    }
    if (g_moving_light.hour >= 24u) {
      g_moving_light.hour = 0u;
      g_moving_light.day++;
    }
    if (g_moving_light.day >
        DaysInMonth(g_moving_light.year, g_moving_light.month)) {
      g_moving_light.day = 1u;
      g_moving_light.month++;
    }
    if (g_moving_light.month > 12u) {
      g_moving_light.month = 1u;
      g_moving_light.year++;
    }
  }
}

const ModelEntry MOVING_LIGHT_MODEL_ENTRY = {
  .model_id = MOVING_LIGHT_MODEL_ID,
  .activate_fn = MovingLightModel_Activate,
  .deactivate_fn = MovingLightModel_Deactivate,
  .ioctl_fn = RDMResponder_Ioctl,
  .request_fn = MovingLightModel_HandleRequest,
  .tasks_fn = MovingLightModel_Tasks
};

static const PIDDescriptor PID_DESCRIPTORS[] = {
  {PID_COMMS_STATUS, RDMResponder_GetCommsStatus, 0u,
    RDMResponder_SetCommsStatus},
  {PID_SUPPORTED_PARAMETERS, RDMResponder_GetSupportedParameters, 0u,
    (PIDCommandHandler) NULL},
  {PID_DEVICE_INFO, RDMResponder_GetDeviceInfo, 0u, (PIDCommandHandler) NULL},
  {PID_PRODUCT_DETAIL_ID_LIST, RDMResponder_GetProductDetailIds, 0u,
    (PIDCommandHandler) NULL},
  {PID_DEVICE_MODEL_DESCRIPTION, RDMResponder_GetDeviceModelDescription, 0u,
    (PIDCommandHandler) NULL},
  {PID_MANUFACTURER_LABEL, RDMResponder_GetManufacturerLabel, 0u,
    (PIDCommandHandler) NULL},
  {PID_DEVICE_LABEL, RDMResponder_GetDeviceLabel, 0u,
    RDMResponder_SetDeviceLabel},
  {PID_FACTORY_DEFAULTS, MovingLightModel_GetFactoryDefaults, 0u,
    MovingLightModel_SetFactoryDefaults},
  {PID_LANGUAGE_CAPABILITIES, MovingLightModel_GetLanguageCapabilities, 0u,
    (PIDCommandHandler) NULL},
  {PID_LANGUAGE, MovingLightModel_GetLanguage, 0u,
    MovingLightModel_SetLanguage},
  {PID_SOFTWARE_VERSION_LABEL, RDMResponder_GetSoftwareVersionLabel, 0u,
    (PIDCommandHandler) NULL},
  {PID_BOOT_SOFTWARE_VERSION_ID, RDMResponder_GetBootSoftwareVersion, 0u,
    (PIDCommandHandler) NULL},
  {PID_BOOT_SOFTWARE_VERSION_LABEL, RDMResponder_GetBootSoftwareVersionLabel,
    0u, (PIDCommandHandler) NULL},
  {PID_DMX_PERSONALITY, RDMResponder_GetDMXPersonality, 0u,
    RDMResponder_SetDMXPersonality},
  {PID_DMX_PERSONALITY_DESCRIPTION, RDMResponder_GetDMXPersonalityDescription,
    1u, (PIDCommandHandler) NULL},
  {PID_DMX_START_ADDRESS, RDMResponder_GetDMXStartAddress, 0u,
    RDMResponder_SetDMXStartAddress},
  {PID_SLOT_INFO, RDMResponder_GetSlotInfo, 0u,
    (PIDCommandHandler) NULL},
  {PID_SLOT_DESCRIPTION, RDMResponder_GetSlotDescription, 2,
    (PIDCommandHandler) NULL},
  {PID_DEFAULT_SLOT_VALUE, RDMResponder_GetDefaultSlotValue, 0u,
    (PIDCommandHandler) NULL},
  {PID_DEVICE_HOURS, MovingLightModel_GetUInt32, 0u,
    MovingLightModel_SetUInt32},
  {PID_LAMP_HOURS, MovingLightModel_GetUInt32, 0u,
    MovingLightModel_SetUInt32},
  {PID_LAMP_STRIKES, MovingLightModel_GetUInt32, 0u,
    MovingLightModel_SetUInt32},
  {PID_LAMP_STATE, MovingLightModel_GetUInt8, 0u,
    MovingLightModel_SetLampState},
  {PID_LAMP_ON_MODE, MovingLightModel_GetUInt8, 0u,
    MovingLightModel_SetLampOnMode},
  {PID_DEVICE_POWER_CYCLES, MovingLightModel_GetUInt32, 0u,
    MovingLightModel_SetUInt32},
  {PID_DISPLAY_INVERT, MovingLightModel_GetUInt8, 0u,
    MovingLightModel_SetDisplayInvert},
  {PID_DISPLAY_LEVEL, MovingLightModel_GetUInt8, 0u, MovingLightModel_SetUInt8},
  {PID_PAN_INVERT, MovingLightModel_GetBool, 0u, MovingLightModel_SetBool},
  {PID_TILT_INVERT, MovingLightModel_GetBool, 0u, MovingLightModel_SetBool},
  {PID_PAN_TILT_SWAP, MovingLightModel_GetBool, 0u, MovingLightModel_SetBool},
  {PID_REAL_TIME_CLOCK, MovingLightModel_GetClock, 0u,
    MovingLightModel_SetClock},
  {PID_IDENTIFY_DEVICE, RDMResponder_GetIdentifyDevice, 0u,
    RDMResponder_SetIdentifyDevice},
  {PID_RESET_DEVICE, (PIDCommandHandler) NULL, 0u,
    MovingLightModel_ResetDevice},
  {PID_POWER_STATE, MovingLightModel_GetUInt8, 0u,
    MovingLightModel_SetPowerState}
};

static const ProductDetailIds PRODUCT_DETAIL_ID_LIST = {
  .ids = {PRODUCT_DETAIL_TEST, PRODUCT_DETAIL_CHANGEOVER_MANUAL,
          PRODUCT_DETAIL_LED},
  .size = 3u
};

static const char SLOT_DIMMER_DESCRIPTION[] = "Dimmer";
static const char SLOT_PAN_DESCRIPTION[] = "Pan";
static const char SLOT_PAN_FINE_DESCRIPTION[] = "Pan (Fine)";
static const char SLOT_TILT_DESCRIPTION[] = "Tilt";
static const char SLOT_TILT_FINE_DESCRIPTION[] = "Tilt (Fine)";
static const char SLOT_COLOR_DESCRIPTION[] = "Color Wheel";

static const SlotDefinition PERSONALITY_SLOTS1[] = {
  {
    .description = SLOT_DIMMER_DESCRIPTION,
    .slot_label_id = SD_INTENSITY,
    .slot_type = ST_PRIMARY,
    .default_value = 0u,
  },
  {
    .description = SLOT_PAN_DESCRIPTION,
    .slot_label_id = SD_PAN,
    .slot_type = ST_PRIMARY,
    .default_value = 127u,
  },
  {
    .description = SLOT_TILT_DESCRIPTION,
    .slot_label_id = SD_TILT,
    .slot_type = ST_PRIMARY,
    .default_value = 127u,
  },
  {
    .description = SLOT_COLOR_DESCRIPTION,
    .slot_label_id = SD_COLOR_WHEEL,
    .slot_type = ST_PRIMARY,
    .default_value = 0,
  }
};

static const SlotDefinition PERSONALITY_SLOTS2[] = {
  {
    .description = SLOT_DIMMER_DESCRIPTION,
    .slot_label_id = SD_INTENSITY,
    .slot_type = ST_PRIMARY,
    .default_value = 0u,
  },
  {
    .description = SLOT_PAN_DESCRIPTION,
    .slot_label_id = SD_PAN,
    .slot_type = ST_PRIMARY,
    .default_value = 127u,
  },
  {
    .description = SLOT_PAN_FINE_DESCRIPTION,
    .slot_label_id = 1u,
    .slot_type = ST_SEC_FINE,
    .default_value = 0u,
  },
  {
    .description = SLOT_TILT_DESCRIPTION,
    .slot_label_id = SD_TILT,
    .slot_type = ST_PRIMARY,
    .default_value = 127u,
  },
  {
    .description = SLOT_TILT_FINE_DESCRIPTION,
    .slot_label_id = 3u,
    .slot_type = ST_SEC_FINE,
    .default_value = 0u,
  },
  {
    .description = SLOT_COLOR_DESCRIPTION,
    .slot_label_id = SD_COLOR_WHEEL,
    .slot_type = ST_PRIMARY,
    .default_value = 0u,
  }
};

static const PersonalityDefinition PERSONALITIES[PERSONALITY_COUNT] = {
  {
    .dmx_footprint = 4u,
    .description = PERSONALITY_DESCRIPTION1,
    .slots = PERSONALITY_SLOTS1,
    .slot_count = 4u
  },
  {
    .dmx_footprint = 6u,
    .description = PERSONALITY_DESCRIPTION2,
    .slots = PERSONALITY_SLOTS2,
    .slot_count = 6u
  }
};

static const ResponderDefinition RESPONDER_DEFINITION = {
  .descriptors = PID_DESCRIPTORS,
  .descriptor_count = sizeof(PID_DESCRIPTORS) / sizeof(PIDDescriptor),
  .sensors = NULL,
  .sensor_count = 0u,
  .personalities = PERSONALITIES,
  .personality_count = PERSONALITY_COUNT,
  .software_version_label = SOFTWARE_LABEL,
  .manufacturer_label = MANUFACTURER_LABEL,
  .model_description = DEVICE_MODEL_DESCRIPTION,
  .product_detail_ids = &PRODUCT_DETAIL_ID_LIST,
  .default_device_label = DEFAULT_DEVICE_LABEL,
  .software_version = SOFTWARE_VERSION,
  .model_id = MOVING_LIGHT_MODEL_ID,
  .product_category = PRODUCT_CATEGORY_TEST_EQUIPMENT
};
