OpenLightingProject/ja-rule/firmware/src/message_handler.c

/*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
 * message_handler.c
 * Copyright (C) 2015 Simon Newton
 */

#include "message_handler.h"

#include <stdlib.h>

#include "system_definitions.h"

#include "app.h"
#include "app_pipeline.h"
#include "constants.h"
#include "flags.h"
#include "peripheral/eth/plib_eth.h"
#include "rdm_frame.h"
#include "rdm_handler.h"
#include "syslog.h"
#include "transceiver.h"

#include "app_settings.h"

#ifndef PIPELINE_TRANSPORT_TX
static TransportTXFunction g_message_tx_cb;
#endif

static inline uint16_t JoinUInt16(uint8_t upper, uint8_t lower) {
  return (upper << 8) + lower;
}

static inline void SendMessage(uint8_t token, Command command, uint8_t rc,
                               const IOVec* iov, unsigned int iov_size) {
#ifdef PIPELINE_TRANSPORT_TX
  PIPELINE_TRANSPORT_TX(token, command, rc, iov, iov_size);
#else
  g_message_tx_cb(token, command, rc, iov, iov_size);
#endif
}

static void Echo(const Message *message) {
  IOVec iovec;
  iovec.base = message->payload;
  iovec.length = message->length;
  SendMessage(message->token, COMMAND_ECHO, RC_OK, &iovec, 1u);
}

static void SetMode(uint8_t token,
                    const uint8_t* payload,
                    unsigned int length) {
  uint8_t mode;
  if (length != sizeof(mode) || payload[0] >= T_MODE_LAST) {
    SendMessage(token, COMMAND_SET_MODE, RC_BAD_PARAM, NULL, 0u);
    return;
  }
  if (!Transceiver_SetMode(payload[0], token)) {
    SendMessage(token, COMMAND_SET_MODE, RC_INVALID_MODE, NULL, 0u);
    return;
  }
}

static void GetHardwareInfo(uint8_t token, unsigned int length) {
  if (length) {
    SendMessage(token, COMMAND_GET_HARDWARE_INFO, RC_BAD_PARAM, NULL, 0u);
    return;
  }

  typedef struct {
    uint16_t model;
    uint8_t uid[UID_LENGTH];
    uint8_t mac[MAC_ADDRESS_SIZE];
  } __attribute__((packed)) HardwareResponse;

  HardwareResponse response;
  response.model = HARDWARE_MODEL;
  RDMHandler_GetUID(response.uid);

  unsigned int i = 0;
  for (; i < MAC_ADDRESS_SIZE; i++) {
    response.mac[i] = PLIB_ETH_StationAddressGet(ETH_ID_0, i + 1);
  }

  IOVec iovec;
  iovec.base = &response;
  iovec.length = sizeof(HardwareResponse);
  SendMessage(token, COMMAND_GET_HARDWARE_INFO, RC_OK, &iovec, 1u);
}

static void RunSelfTest(uint8_t token, unsigned int length) {
  if (length) {
    SendMessage(token, COMMAND_RUN_SELF_TEST, RC_BAD_PARAM, NULL, 0u);
    return;
  }

  if (!Transceiver_QueueSelfTest(token)) {
    SendMessage(token, COMMAND_RUN_SELF_TEST, RC_TEST_FAILED, NULL, 0u);
  }
}

static void SetBreakTime(uint8_t token,
                         const uint8_t* payload,
                         unsigned int length) {
  uint16_t break_time;
  if (length != sizeof(break_time)) {
    SendMessage(token, COMMAND_SET_BREAK_TIME, RC_BAD_PARAM, NULL, 0u);
    return;
  }

  break_time = JoinUInt16(payload[1], payload[0]);
  bool ok = Transceiver_SetBreakTime(break_time);
  SendMessage(token, COMMAND_SET_BREAK_TIME, ok ? RC_OK : RC_BAD_PARAM,
              NULL, 0);
}

static void ReturnBreakTime(uint8_t token, unsigned int length) {
  if (length) {
    SendMessage(token, COMMAND_GET_BREAK_TIME, RC_BAD_PARAM, NULL, 0u);
    return;
  }

  uint16_t break_time = Transceiver_GetBreakTime();
  IOVec iovec;
  iovec.base = (uint8_t*) &break_time;
  iovec.length = sizeof(break_time);
  SendMessage(token, COMMAND_GET_BREAK_TIME, RC_OK, &iovec, 1u);
}

static void SetMarkTime(uint8_t token,
                        const uint8_t* payload,
                        unsigned int length) {
  uint16_t mark_time;
  if (length != sizeof(mark_time)) {
    SendMessage(token, COMMAND_SET_MARK_TIME, RC_BAD_PARAM, NULL, 0u);
    return;
  }

  mark_time = JoinUInt16(payload[1], payload[0]);
  bool ok = Transceiver_SetMarkTime(mark_time);
  SendMessage(token, COMMAND_SET_MARK_TIME, ok ? RC_OK : RC_BAD_PARAM, NULL,
              0u);
}

static void ReturnMarkTime(uint8_t token, unsigned int length) {
  if (length) {
    SendMessage(token, COMMAND_GET_MARK_TIME, RC_BAD_PARAM, NULL, 0u);
    return;
  }

  uint16_t mab_time = Transceiver_GetMarkTime();
  IOVec iovec;
  iovec.base = (uint8_t*) &mab_time;
  iovec.length = sizeof(mab_time);
  SendMessage(token, COMMAND_GET_MARK_TIME, RC_OK, &iovec, 1u);
}

static void SetRDMBroadcastTimeout(uint8_t token,
                                   const uint8_t* payload,
                                   unsigned int length) {
  uint16_t time;
  if (length != sizeof(time)) {
    SendMessage(token, COMMAND_SET_RDM_BROADCAST_TIMEOUT, RC_BAD_PARAM, NULL,
                0u);
    return;
  }

  time = JoinUInt16(payload[1], payload[0]);
  bool ok = Transceiver_SetRDMBroadcastTimeout(time);
  SendMessage(token, COMMAND_SET_RDM_BROADCAST_TIMEOUT,
              ok ? RC_OK : RC_BAD_PARAM, NULL, 0u);
}

static void ReturnRDMBroadcastTimeout(uint8_t token, unsigned int length) {
  if (length) {
    SendMessage(token, COMMAND_GET_RDM_BROADCAST_TIMEOUT, RC_BAD_PARAM, NULL,
                0u);
    return;
  }
  uint16_t time = Transceiver_GetRDMBroadcastTimeout();
  IOVec iovec;
  iovec.base = (uint8_t*) &time;
  iovec.length = sizeof(time);
  SendMessage(token, COMMAND_GET_RDM_BROADCAST_TIMEOUT, RC_OK, &iovec, 1u);
}

static void SetRDMResponseTimeout(
    uint8_t token,
    const uint8_t* payload,
    unsigned int length) {
  uint16_t timeout;
  if (length != sizeof(timeout)) {
    SendMessage(token, COMMAND_SET_RDM_RESPONSE_TIMEOUT, RC_BAD_PARAM, NULL,
                0u);
    return;
  }

  timeout = JoinUInt16(payload[1], payload[0]);
  bool ok = Transceiver_SetRDMResponseTimeout(timeout);
  SendMessage(token, COMMAND_SET_RDM_RESPONSE_TIMEOUT,
              ok ? RC_OK : RC_BAD_PARAM, NULL, 0u);
}

static void ReturnRDMResponseTimeout(
    uint8_t token,
    unsigned int length) {
  if (length) {
    SendMessage(token, COMMAND_GET_RDM_RESPONSE_TIMEOUT, RC_BAD_PARAM, NULL,
                0u);
    return;
  }
  uint16_t timeout = Transceiver_GetRDMResponseTimeout();
  IOVec iovec;
  iovec.base = (uint8_t*) &timeout;
  iovec.length = sizeof(timeout);
  SendMessage(token, COMMAND_GET_RDM_RESPONSE_TIMEOUT, RC_OK, &iovec, 1u);
}

static void SetRDMDUBResponseLimit(uint8_t token,
                                   const uint8_t* payload,
                                   unsigned int length) {
  uint16_t limit;
  if (length != sizeof(limit)) {
    SendMessage(token, COMMAND_SET_RDM_DUB_RESPONSE_LIMIT, RC_BAD_PARAM, NULL,
                0u);
    return;
  }

  limit = JoinUInt16(payload[1], payload[0]);
  bool ok = Transceiver_SetRDMDUBResponseLimit(limit);
  SendMessage(token, COMMAND_SET_RDM_DUB_RESPONSE_LIMIT,
              ok ? RC_OK : RC_BAD_PARAM, NULL, 0u);
}

static void ReturnRDMDUBResponseLimit(uint8_t token, unsigned int length) {
  if (length) {
    SendMessage(token, COMMAND_GET_RDM_DUB_RESPONSE_LIMIT, RC_BAD_PARAM,
                NULL, 0u);
    return;
  }
  uint16_t limit = Transceiver_GetRDMDUBResponseLimit();
  IOVec iovec;
  iovec.base = (uint8_t*) &limit;
  iovec.length = sizeof(limit);
  SendMessage(token, COMMAND_GET_RDM_DUB_RESPONSE_LIMIT, RC_OK, &iovec, 1u);
}

static void SetRDMResponderDelay(uint8_t token,
                                 const uint8_t* payload,
                                 unsigned int length) {
  uint16_t delay;
  if (length != sizeof(delay)) {
    SendMessage(token, COMMAND_SET_RDM_RESPONDER_DELAY, RC_BAD_PARAM, NULL, 0u);
    return;
  }

  delay = JoinUInt16(payload[1], payload[0]);
  bool ok = Transceiver_SetRDMResponderDelay(delay);
  SendMessage(token, COMMAND_SET_RDM_RESPONDER_DELAY,
              ok ? RC_OK : RC_BAD_PARAM, NULL, 0u);
}

static void ReturnRDMResponderDelay(uint8_t token, unsigned int length) {
  if (length) {
    SendMessage(token, COMMAND_GET_RDM_RESPONDER_DELAY, RC_BAD_PARAM,
                NULL, 0u);
    return;
  }
  uint16_t delay = Transceiver_GetRDMResponderDelay();
  IOVec iovec;
  iovec.base = (uint8_t*) &delay;
  iovec.length = sizeof(delay);
  SendMessage(token, COMMAND_GET_RDM_RESPONDER_DELAY, RC_OK, &iovec, 1u);
}

static void SetRDMResponderJitter(uint8_t token,
                                  const uint8_t* payload,
                                  unsigned int length) {
  uint16_t jitter;
  if (length != sizeof(jitter)) {
    SendMessage(token, COMMAND_SET_RDM_RESPONDER_JITTER, RC_BAD_PARAM, NULL,
                0u);
    return;
  }

  jitter = JoinUInt16(payload[1], payload[0]);
  bool ok = Transceiver_SetRDMResponderJitter(jitter);
  SendMessage(token, COMMAND_SET_RDM_RESPONDER_JITTER,
              ok ? RC_OK : RC_BAD_PARAM, NULL, 0u);
}

static void ReturnRDMResponderJitter(uint8_t token, unsigned int length) {
  if (length) {
    SendMessage(token, COMMAND_GET_RDM_RESPONDER_JITTER, RC_BAD_PARAM,
                NULL, 0u);
    return;
  }
  uint16_t jitter = Transceiver_GetRDMResponderJitter();
  IOVec iovec;
  iovec.base = (uint8_t*) &jitter;
  iovec.length = sizeof(jitter);
  SendMessage(token, COMMAND_GET_RDM_RESPONDER_JITTER, RC_OK, &iovec, 1u);
}

static bool CheckForTXMode(const Message *message) {
  if (Transceiver_GetMode() == T_MODE_CONTROLLER) {
    return true;
  }
  SendMessage(message->token, message->command, RC_INVALID_MODE, NULL, 0u);
  return false;
}

// Public Functions
// ----------------------------------------------------------------------------
void MessageHandler_Initialize(TransportTXFunction tx_cb) {
#ifndef PIPELINE_TRANSPORT_TX
  g_message_tx_cb = tx_cb;
#endif
}

void MessageHandler_HandleMessage(const Message *message) {
  switch (message->command) {
    case COMMAND_ECHO:
      Echo(message);
      break;
    case TX_DMX:
      if (CheckForTXMode(message) &&
          !Transceiver_QueueDMX(message->token, message->payload,
                                message->length)) {
        SendMessage(message->token, message->command, RC_BUFFER_FULL, NULL, 0u);
      }
      break;
    case GET_FLAGS:
      Flags_SendResponse(message->token);
      break;
    case COMMAND_RESET_DEVICE:
      APP_Reset();
      SendMessage(message->token, message->command, RC_OK, NULL, 0u);
      break;
    case COMMAND_SET_MODE:
      SetMode(message->token, message->payload, message->length);
      break;
    case COMMAND_GET_HARDWARE_INFO:
      GetHardwareInfo(message->token, message->length);
      break;
    case COMMAND_RUN_SELF_TEST:
      RunSelfTest(message->token, message->length);
      break;
    case COMMAND_RDM_DUB_REQUEST:
      if (CheckForTXMode(message) &&
          !Transceiver_QueueRDMDUB(message->token, message->payload,
                                   message->length)) {
        SendMessage(message->token, message->command, RC_BUFFER_FULL, NULL, 0u);
      }
      break;
    case COMMAND_RDM_REQUEST:
      if (CheckForTXMode(message) &&
          !Transceiver_QueueRDMRequest(message->token, message->payload,
                                       message->length, false)) {
        SendMessage(message->token, message->command, RC_BUFFER_FULL, NULL, 0u);
      }
      break;
    case COMMAND_SET_BREAK_TIME:
      SetBreakTime(message->token, message->payload, message->length);
      break;
    case COMMAND_GET_BREAK_TIME:
      ReturnBreakTime(message->token, message->length);
      break;
    case COMMAND_SET_MARK_TIME:
      SetMarkTime(message->token, message->payload, message->length);
      break;
    case COMMAND_GET_MARK_TIME:
      ReturnMarkTime(message->token, message->length);
      break;
    case COMMAND_SET_RDM_BROADCAST_TIMEOUT:
      SetRDMBroadcastTimeout(message->token, message->payload, message->length);
      break;
    case COMMAND_GET_RDM_BROADCAST_TIMEOUT:
      ReturnRDMBroadcastTimeout(message->token, message->length);
      break;
    case COMMAND_SET_RDM_RESPONSE_TIMEOUT:
      SetRDMResponseTimeout(message->token, message->payload, message->length);
      break;
    case COMMAND_GET_RDM_RESPONSE_TIMEOUT:
      ReturnRDMResponseTimeout(message->token, message->length);
      break;
    case COMMAND_SET_RDM_DUB_RESPONSE_LIMIT:
      SetRDMDUBResponseLimit(message->token, message->payload, message->length);
      break;
    case COMMAND_GET_RDM_DUB_RESPONSE_LIMIT:
      ReturnRDMDUBResponseLimit(message->token, message->length);
      break;
    case COMMAND_SET_RDM_RESPONDER_DELAY:
      SetRDMResponderDelay(message->token, message->payload, message->length);
      break;
    case COMMAND_GET_RDM_RESPONDER_DELAY:
      ReturnRDMResponderDelay(message->token, message->length);
      break;
    case COMMAND_SET_RDM_RESPONDER_JITTER:
      SetRDMResponderJitter(message->token, message->payload, message->length);
      break;
    case COMMAND_GET_RDM_RESPONDER_JITTER:
      ReturnRDMResponderJitter(message->token, message->length);
      break;

    case COMMAND_RDM_BROADCAST_REQUEST:
      if (CheckForTXMode(message) &&
          !Transceiver_QueueRDMRequest(message->token, message->payload,
                                       message->length, true)) {
        SendMessage(message->token, message->command, RC_BUFFER_FULL, NULL, 0u);
      }
      break;

    default:
      // Just echo the command code back if we don't understand it.
      SendMessage(message->token, message->command, RC_UNKNOWN, NULL, 0u);
  }
}

void MessageHandler_TransceiverEvent(const TransceiverEvent *event) {
  uint8_t vector_size = 0u;
  IOVec iovec[2];

  Command command;
  ReturnCode rc;
  switch (event->result) {
    case T_RESULT_OK:
      rc = RC_OK;
      break;
    case T_RESULT_TX_ERROR:
      rc = RC_TX_ERROR;
      break;
    case T_RESULT_RX_DATA:
      rc = (event->op == T_OP_RDM_BROADCAST ? RC_RDM_BCAST_RESPONSE : RC_OK);
      break;
    case T_RESULT_RX_TIMEOUT:
      rc = (event->op == T_OP_RDM_BROADCAST ? RC_OK : RC_RDM_TIMEOUT);
      break;
    case T_RESULT_RX_INVALID:
      rc = RC_RDM_INVALID_RESPONSE;
      break;
    case T_RESULT_CANCELLED:
      rc = RC_CANCELLED;
      break;
    case T_RESULT_SELF_TEST_FAILED:
      rc = RC_TEST_FAILED;
      break;
    default:
      rc = RC_UNKNOWN;
  }

  switch (event->op) {
    case T_OP_TX_ONLY:
      command = TX_DMX;
      break;
    case T_OP_RDM_DUB:
      command = COMMAND_RDM_DUB_REQUEST;
      iovec[vector_size].base = &event->timing->dub_response;
      iovec[vector_size].length = sizeof(event->timing->dub_response);
      vector_size++;
      break;
    case T_OP_RDM_WITH_RESPONSE:
      command = COMMAND_RDM_REQUEST;
      iovec[vector_size].base = &event->timing->get_set_response;
      iovec[vector_size].length = sizeof(event->timing->get_set_response);
      vector_size++;
      break;
    case T_OP_RDM_BROADCAST:
      command = COMMAND_RDM_BROADCAST_REQUEST;
      break;
    case T_OP_SELF_TEST:
      command = COMMAND_RUN_SELF_TEST;
      break;
    case T_OP_MODE_CHANGE:
      command = COMMAND_SET_MODE;
      break;
    default:
      SysLog_Print(SYSLOG_INFO, "Unknown Transceiver op %d", event->op);
      return;
  }

  if (event->data && event->length > 0) {
    iovec[vector_size].base = event->data;
    iovec[vector_size].length = event->length;
    vector_size++;
  }

  SendMessage(event->token, command, rc, (IOVec*) &iovec, vector_size);
  SysLog_Print(SYSLOG_INFO, "Token %d, op %d, result: %d",
               event->token, event->op, event->result);
}
