OpenLightingProject/ja-rule/firmware/src/spi.h

/*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
 * spi.h
 * Copyright (C) 2015 Simon Newton
 */

/**
 * @defgroup spi SPI
 * @brief SPI Driver
 *
 * This driver allows multiple clients to share the SPI bus. This assumes that
 * all clients use the same SPI configuration. If that isn't the case we'll
 * need to introduce client handles or something.
 *
 * Clients can queue an SPI transfer with the SPI_QueueTransfer() method. The
 * callback argument can be used to specify a callback to be run before and
 * after the transfer is performed. This callback can be used to set the
 * relevant chip-enable line.
 *
 * @addtogroup spi
 * @{
 * @file spi.h
 * @brief SPI Driver
 */

#ifndef FIRMWARE_SRC_SPI_H_
#define FIRMWARE_SRC_SPI_H_

#include <stdbool.h>
#include <stdint.h>

#ifdef __cplusplus
extern "C" {
#endif

/**
 * @brief SPI Event types.
 */
typedef enum {
  SPI_BEGIN_TRANSFER,
  SPI_COMPLETE_TRANSFER
} SPIEventType;

/**
 * @brief The callback run before and after the SPI transfer begins.
 * @param event The type of SPI event that occurs.
 */
typedef void (*SPI_Callback)(SPIEventType event);

/**
 * @brief Queue an SPI transfer.
 * @param output The output buffer to send, may be NULL.
 * @param output_length The size of the output buffer.
 * @param input The location to store received data, may be NULL.
 * @param input_length The length of the input data buffer.
 * @param callback The callback run prior and post this transfer.
 * @returns True if the transfer was scheduled, false if the queue was full.
 *
 * This queues a write / read SPI operation. First the data in output will be
 * sent, then input_length worth of data will be read while 0s are sent. Both
 * stages are optional.
 *
 * The total number of bytes sent will be the sum of (output_length,
 * input_length).
 */
bool SPI_QueueTransfer(const uint8_t *output,
                       unsigned int output_length,
                       uint8_t *input,
                       unsigned int input_length,
                       SPI_Callback callback);
/**
 * @brief Initialize the SPI driver.
 */
void SPI_Initialize();

/**
 * @brief The tasks function, this should be called from the main event loop.
 */
void SPI_Tasks();

#ifdef __cplusplus
}
#endif

#endif  // FIRMWARE_SRC_SPI_H_

/**
 * @}
 */
