OpenLightingProject/ja-rule/tests/sim/InterruptController.h

/*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
 * InterruptController.h
 * The interrupt controller for the simulator.
 * Copyright (C) 2015 Simon Newton
 */

#ifndef TESTS_SIM_INTERRUPTCONTROLLER_H_
#define TESTS_SIM_INTERRUPTCONTROLLER_H_

#include <map>
#include "ola/Callback.h"
#include "sys_int_mock.h"

class InterruptController : public SysIntInterface {
 public:
  typedef ola::Callback0<void> ISRCallback;

  ~InterruptController();

  // Ownership of the callback is transferred.
  void RegisterISR(INT_SOURCE source, ISRCallback *callback);

  void RaiseInterrupt(INT_SOURCE source);

  bool SourceStatusGet(INT_SOURCE source);
  void SourceStatusClear(INT_SOURCE source);
  void SourceEnable(INT_SOURCE source);
  bool SourceDisable(INT_SOURCE source);
  void VectorPrioritySet(INT_VECTOR vector,
                         INT_PRIORITY_LEVEL priority);
  void VectorSubprioritySet(INT_VECTOR vector,
                            INT_SUBPRIORITY_LEVEL subpriority);

 private:
  struct Interrupt {
   public:
    Interrupt();
    ~Interrupt();

    bool enabled;
    bool active;
    ISRCallback *callback;
  };

  std::map<INT_SOURCE, Interrupt*> m_interrupts;

  Interrupt *GetInterrupt(INT_SOURCE source);
};

#endif  // TESTS_SIM_INTERRUPTCONTROLLER_H_
