OpenLightingProject/ja-rule/tests/sim/InterruptController.cpp

/*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
 * InterruptController.cpp
 * The interrupt controller for the simulator.
 * Copyright (C) 2015 Simon Newton
 */

#include "InterruptController.h"

#include <map>

#include "macros.h"
#include "ola/Callback.h"
#include "ola/stl/STLUtils.h"

InterruptController::Interrupt::Interrupt()
    : enabled(false),
      active(false),
      callback(nullptr) {
}

InterruptController::Interrupt::~Interrupt() {
  if (callback) {
    delete callback;
  }
}

InterruptController::~InterruptController() {
  ola::STLDeleteValues(&m_interrupts);
}

void InterruptController::RegisterISR(INT_SOURCE source,
                                      ISRCallback *callback) {
  Interrupt *interrupt = GetInterrupt(source);
  if (interrupt->callback) {
    delete interrupt->callback;
  }
  interrupt->callback = callback;
}

void InterruptController::RaiseInterrupt(INT_SOURCE source) {
  Interrupt *interrupt = GetInterrupt(source);
  interrupt->active = true;
  if (!interrupt->enabled) {
    return;
  }

  while (interrupt->active) {
    if (interrupt->callback) {
      // The ISR is responsible for clearing the active flag
      interrupt->callback->Run();
    } else {
      FAIL() << "Interrupt " << source << " is active but no callback set!";
    }
  }
}

bool InterruptController::SourceStatusGet(INT_SOURCE source) {
  Interrupt *interrupt = GetInterrupt(source);
  return interrupt->active;
}

void InterruptController::SourceStatusClear(INT_SOURCE source) {
  Interrupt *interrupt = GetInterrupt(source);
  interrupt->active = false;
}

void InterruptController::SourceEnable(INT_SOURCE source) {
  Interrupt *interrupt = GetInterrupt(source);
  interrupt->enabled = true;
}

bool InterruptController::SourceDisable(INT_SOURCE source) {
  Interrupt *interrupt = GetInterrupt(source);
  interrupt->enabled = false;
  return true;
}

void InterruptController::VectorPrioritySet(
    UNUSED INT_VECTOR vector,
    UNUSED INT_PRIORITY_LEVEL priority) {
}

void InterruptController::VectorSubprioritySet(
    UNUSED INT_VECTOR vector,
    UNUSED INT_SUBPRIORITY_LEVEL subpriority) {
}

InterruptController::Interrupt *InterruptController::GetInterrupt(
    INT_SOURCE source) {
  return ola::STLLookupOrInsertNew(&m_interrupts, source)->second;
}
