OpenLightingProject/ja-rule/tests/tests/NetworkModelTest.cpp

/*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
 * NetworkModelTest.cpp
 * Tests for the Network Model RDM responder.
 * Copyright (C) 2015 Simon Newton
 */

#include <gtest/gtest.h>

#include <ola/rdm/UID.h>
#include <ola/rdm/RDMCommand.h>
#include <ola/rdm/RDMEnums.h>
#include <ola/rdm/RDMCommandSerializer.h>
#include <ola/network/NetworkUtils.h>
#include <string.h>
#include <memory>

#include "network_model.h"
#include "rdm.h"
#include "rdm_buffer.h"
#include "rdm_responder.h"
#include "Array.h"
#include "Matchers.h"
#include "ModelTest.h"
#include "TestHelpers.h"

using ola::network::HostToNetwork;
using ola::rdm::UID;
using ola::rdm::GetResponseFromData;
using ola::rdm::NackWithReason;
using ola::rdm::RDMRequest;
using ola::rdm::RDMResponse;
using std::unique_ptr;
using ::testing::NotNull;

class NetworkModelTest : public ModelTest {
 public:
  NetworkModelTest() : ModelTest(&NETWORK_MODEL_ENTRY) {}

  void SetUp() {
    RDMResponderSettings settings;
    memcpy(settings.uid, TEST_UID, UID_LENGTH);
    RDMResponder_Initialize(&settings);
    NetworkModel_Initialize();
    NETWORK_MODEL_ENTRY.activate_fn();
  }
};

TEST_F(NetworkModelTest, testLifecycle) {
  EXPECT_EQ(NETWORK_MODEL_ID, NETWORK_MODEL_ENTRY.model_id);
  NETWORK_MODEL_ENTRY.tasks_fn();
  NETWORK_MODEL_ENTRY.deactivate_fn();
}

TEST_F(NetworkModelTest, listInterfaces) {
  // Get the list of interfaces
  unique_ptr<RDMRequest> request = BuildGetRequest(PID_LIST_INTERFACES);

  const uint8_t expected_response[] = {
    0x00, 0x00, 0x00, 0x01, 0x00, 0x01,
    0x00, 0x00, 0x00, 0x03, 0x00, 0x1f,
    0x00, 0x00, 0x00, 0x04, 0x00, 0x01,
  };

  unique_ptr<RDMResponse> response(GetResponseFromData(
        request.get(), expected_response, arraysize(expected_response)));

  int size = InvokeRDMHandler(request.get());
  EXPECT_THAT(ArrayTuple(g_rdm_buffer, size), ResponseIs(response.get()));
}

TEST_F(NetworkModelTest, getInterfaceLabel) {
  // Get the label for the first interface.
  uint32_t interface_id = HostToNetwork(1);
  unique_ptr<RDMRequest> request = BuildGetRequest(PID_INTERFACE_LABEL,
      reinterpret_cast<uint8_t*>(&interface_id), sizeof(interface_id));

  const uint8_t expected_response[] = {
    0x00, 0x00, 0x00, 0x01,
    'e', 't', 'h', '0'
  };

  unique_ptr<RDMResponse> response(GetResponseFromData(
        request.get(), expected_response, arraysize(expected_response)));

  int size = InvokeRDMHandler(request.get());
  EXPECT_THAT(ArrayTuple(g_rdm_buffer, size), ResponseIs(response.get()));

  // test the NR_DATA_OUT_OF_RANGE
  interface_id = HostToNetwork(2);
  request = BuildGetRequest(PID_INTERFACE_LABEL,
      reinterpret_cast<uint8_t*>(&interface_id), sizeof(interface_id));

  response.reset(NackWithReason(request.get(), ola::rdm::NR_DATA_OUT_OF_RANGE));
  size = InvokeRDMHandler(request.get());
  EXPECT_THAT(ArrayTuple(g_rdm_buffer, size), ResponseIs(response.get()));
}

TEST_F(NetworkModelTest, getHardwareAddress) {
  // Get the hardware address for the first interface.
  uint32_t interface_id = HostToNetwork(1);
  unique_ptr<RDMRequest> request = BuildGetRequest(
      PID_INTERFACE_HARDWARE_ADDRESS_TYPE1,
      reinterpret_cast<uint8_t*>(&interface_id), sizeof(interface_id));

  const uint8_t expected_response[] = {
    0x00, 0x00, 0x00, 0x01,
    0x52, 0x12, 0x34, 0x56, 0x78, 0x9a
  };

  unique_ptr<RDMResponse> response(GetResponseFromData(
        request.get(), expected_response, arraysize(expected_response)));

  int size = InvokeRDMHandler(request.get());
  EXPECT_THAT(ArrayTuple(g_rdm_buffer, size), ResponseIs(response.get()));

  // test the NR_DATA_OUT_OF_RANGE if the interface doesn't have a h/w address
  interface_id = HostToNetwork(3);
  request = BuildGetRequest(PID_INTERFACE_HARDWARE_ADDRESS_TYPE1,
      reinterpret_cast<uint8_t*>(&interface_id), sizeof(interface_id));

  response.reset(NackWithReason(request.get(), ola::rdm::NR_DATA_OUT_OF_RANGE));
  size = InvokeRDMHandler(request.get());
  EXPECT_THAT(ArrayTuple(g_rdm_buffer, size), ResponseIs(response.get()));

  // test the NR_DATA_OUT_OF_RANGE for an interface that doesn't exist.
  interface_id = HostToNetwork(5);
  request = BuildGetRequest(PID_INTERFACE_HARDWARE_ADDRESS_TYPE1,
      reinterpret_cast<uint8_t*>(&interface_id), sizeof(interface_id));

  response.reset(NackWithReason(request.get(), ola::rdm::NR_DATA_OUT_OF_RANGE));
  size = InvokeRDMHandler(request.get());
  EXPECT_THAT(ArrayTuple(g_rdm_buffer, size), ResponseIs(response.get()));
}

TEST_F(NetworkModelTest, dhcpMode) {
  // Get the DHCP mode for the first interface.
  uint32_t interface_id = HostToNetwork(1);
  unique_ptr<RDMRequest> request = BuildGetRequest(
      PID_IPV4_DHCP_MODE,
      reinterpret_cast<uint8_t*>(&interface_id), sizeof(interface_id));

  const uint8_t expected_response[] = {
    0x00, 0x00, 0x00, 0x01, 0x00
  };

  unique_ptr<RDMResponse> response(GetResponseFromData(
        request.get(), expected_response, arraysize(expected_response)));

  int size = InvokeRDMHandler(request.get());
  EXPECT_THAT(ArrayTuple(g_rdm_buffer, size), ResponseIs(response.get()));

  // Get the DHCP mode for the second (id 4) interface.
  interface_id = HostToNetwork(4);
  request = BuildGetRequest(PID_IPV4_DHCP_MODE,
      reinterpret_cast<uint8_t*>(&interface_id), sizeof(interface_id));

  const uint8_t expected_response2[] = {
    0x00, 0x00, 0x00, 0x04, 0x01
  };
  response.reset(GetResponseFromData(
        request.get(), expected_response2, arraysize(expected_response2)));

  size = InvokeRDMHandler(request.get());
  EXPECT_THAT(ArrayTuple(g_rdm_buffer, size), ResponseIs(response.get()));

  request = BuildGetRequest(PID_IPV4_DHCP_MODE,
      reinterpret_cast<uint8_t*>(&interface_id), sizeof(interface_id));

  // Toggle DHCP mode on the first interface.
  const uint8_t set_param_data[] = { 0x00, 0x00, 0x00, 0x01, 0x01 };

  request = BuildSetRequest(PID_IPV4_DHCP_MODE, set_param_data,
                            arraysize(set_param_data));
  response.reset(GetResponseFromData(request.get()));

  size = InvokeRDMHandler(request.get());
  EXPECT_THAT(ArrayTuple(g_rdm_buffer, size), ResponseIs(response.get()));

  // And read it back to confirm
  interface_id = HostToNetwork(1);
  request = BuildGetRequest(
      PID_IPV4_DHCP_MODE,
      reinterpret_cast<uint8_t*>(&interface_id), sizeof(interface_id));

  const uint8_t expected_response3[] = {
    0x00, 0x00, 0x00, 0x01, 0x01
  };

  response.reset(GetResponseFromData(
        request.get(), expected_response3, arraysize(expected_response3)));
  size = InvokeRDMHandler(request.get());
  EXPECT_THAT(ArrayTuple(g_rdm_buffer, size), ResponseIs(response.get()));
}

TEST_F(NetworkModelTest, getZeroconfMode) {
  // Get the zeroconf mode for the first interface.
  uint32_t interface_id = HostToNetwork(1);
  unique_ptr<RDMRequest> request = BuildGetRequest(
      PID_IPV4_ZEROCONF_MODE,
      reinterpret_cast<uint8_t*>(&interface_id), sizeof(interface_id));

  const uint8_t expected_response[] = {
    0x00, 0x00, 0x00, 0x01, 0x00
  };

  unique_ptr<RDMResponse> response(GetResponseFromData(
        request.get(), expected_response, arraysize(expected_response)));

  int size = InvokeRDMHandler(request.get());
  EXPECT_THAT(ArrayTuple(g_rdm_buffer, size), ResponseIs(response.get()));

  // Get the zeroconf mode for the second (id 4) interface.
  interface_id = HostToNetwork(4);
  request = BuildGetRequest(PID_IPV4_ZEROCONF_MODE,
      reinterpret_cast<uint8_t*>(&interface_id), sizeof(interface_id));

  const uint8_t expected_response2[] = {
    0x00, 0x00, 0x00, 0x04, 0x01
  };
  response.reset(GetResponseFromData(
        request.get(), expected_response2, arraysize(expected_response2)));

  size = InvokeRDMHandler(request.get());
  EXPECT_THAT(ArrayTuple(g_rdm_buffer, size), ResponseIs(response.get()));

  // Toggle zeroconf mode on the first interface.
  const uint8_t set_param_data[] = { 0x00, 0x00, 0x00, 0x01, 0x01 };

  request = BuildSetRequest(PID_IPV4_ZEROCONF_MODE, set_param_data,
                            arraysize(set_param_data));
  response.reset(GetResponseFromData(request.get()));

  size = InvokeRDMHandler(request.get());
  EXPECT_THAT(ArrayTuple(g_rdm_buffer, size), ResponseIs(response.get()));

  // And read it back to confirm
  interface_id = HostToNetwork(1);
  request = BuildGetRequest(
      PID_IPV4_ZEROCONF_MODE,
      reinterpret_cast<uint8_t*>(&interface_id), sizeof(interface_id));

  const uint8_t expected_response3[] = {
    0x00, 0x00, 0x00, 0x01, 0x01
  };

  response.reset(GetResponseFromData(
        request.get(), expected_response3, arraysize(expected_response3)));
  size = InvokeRDMHandler(request.get());
  EXPECT_THAT(ArrayTuple(g_rdm_buffer, size), ResponseIs(response.get()));
}

TEST_F(NetworkModelTest, currentAddress) {
  // Get the current address for the first interface.
  uint32_t interface_id = HostToNetwork(1);
  unique_ptr<RDMRequest> request = BuildGetRequest(
      PID_IPV4_CURRENT_ADDRESS,
      reinterpret_cast<uint8_t*>(&interface_id), sizeof(interface_id));

  const uint8_t expected_response[] = {
    0x00, 0x00, 0x00, 0x01,
    0xc0, 0xa8, 0x00, 0x01,
    0x18, 0x00
  };

  unique_ptr<RDMResponse> response(GetResponseFromData(
        request.get(), expected_response, arraysize(expected_response)));

  int size = InvokeRDMHandler(request.get());
  EXPECT_THAT(ArrayTuple(g_rdm_buffer, size), ResponseIs(response.get()));

  // test the NR_DATA_OUT_OF_RANGE
  interface_id = HostToNetwork(5);
  request = BuildGetRequest(PID_IPV4_CURRENT_ADDRESS,
      reinterpret_cast<uint8_t*>(&interface_id), sizeof(interface_id));
  response.reset(NackWithReason(request.get(), ola::rdm::NR_DATA_OUT_OF_RANGE));

  size = InvokeRDMHandler(request.get());
  EXPECT_THAT(ArrayTuple(g_rdm_buffer, size), ResponseIs(response.get()));
}


TEST_F(NetworkModelTest, staticAddressWithReconfiguration) {
  // Set static address
  const uint8_t param_data[] = {
    0x00, 0x00, 0x00, 0x01,
    0xac, 0x10, 0x1, 0x2,
    0x08
  };

  unique_ptr<RDMRequest> request = BuildSetRequest(
      PID_IPV4_STATIC_ADDRESS, param_data, arraysize(param_data));
  unique_ptr<RDMResponse> response(GetResponseFromData(request.get()));

  int size = InvokeRDMHandler(request.get());
  EXPECT_THAT(ArrayTuple(g_rdm_buffer, size), ResponseIs(response.get()));

  // Read it back
  uint32_t interface_id = HostToNetwork(1);
  request = BuildGetRequest(PID_IPV4_STATIC_ADDRESS,
                            reinterpret_cast<uint8_t*>(&interface_id),
                            sizeof(interface_id));
  response.reset(GetResponseFromData(request.get(), param_data,
                                     arraysize(param_data)));

  size = InvokeRDMHandler(request.get());
  EXPECT_THAT(ArrayTuple(g_rdm_buffer, size), ResponseIs(response.get()));

  // Now reconfigure the interface
  request = BuildSetRequest(PID_INTERFACE_APPLY_CONFIGURATION,
                            reinterpret_cast<uint8_t*>(&interface_id),
                            sizeof(interface_id));
  response.reset(GetResponseFromData(request.get()));

  size = InvokeRDMHandler(request.get());
  EXPECT_THAT(ArrayTuple(g_rdm_buffer, size), ResponseIs(response.get()));

  // Fetch the current config.
  const uint8_t expected_response[] = {
    0x00, 0x00, 0x00, 0x01,
    0xac, 0x10, 0x1, 0x2,
    0x08, 0x00
  };
  request = BuildGetRequest(PID_IPV4_CURRENT_ADDRESS,
                            reinterpret_cast<uint8_t*>(&interface_id),
                            sizeof(interface_id));
  response.reset(GetResponseFromData(request.get(), expected_response,
                                     arraysize(expected_response)));
  size = InvokeRDMHandler(request.get());
  EXPECT_THAT(ArrayTuple(g_rdm_buffer, size), ResponseIs(response.get()));
}

TEST_F(NetworkModelTest, renewDHCP) {
  uint32_t interface_id = HostToNetwork(4);
  unique_ptr<RDMRequest> request = BuildSetRequest(
      PID_INTERFACE_RENEW_DHCP,
      reinterpret_cast<uint8_t*>(&interface_id),
      sizeof(interface_id));
  unique_ptr<RDMResponse> response(GetResponseFromData(request.get()));
  unsigned int size = InvokeRDMHandler(request.get());
  EXPECT_THAT(ArrayTuple(g_rdm_buffer, size), ResponseIs(response.get()));

  interface_id = HostToNetwork(1);
  request = (BuildSetRequest(PID_INTERFACE_RENEW_DHCP,
                             reinterpret_cast<uint8_t*>(&interface_id),
                             sizeof(interface_id)));
  response.reset(NackWithReason(request.get(),
                                ola::rdm::NR_ACTION_NOT_SUPPORTED));
  size = InvokeRDMHandler(request.get());
  EXPECT_THAT(ArrayTuple(g_rdm_buffer, size), ResponseIs(response.get()));
}

TEST_F(NetworkModelTest, releaseDHCP) {
  uint32_t interface_id = HostToNetwork(4);
  unique_ptr<RDMRequest> request = BuildSetRequest(
      PID_INTERFACE_RELEASE_DHCP,
      reinterpret_cast<uint8_t*>(&interface_id),
      sizeof(interface_id));
  unique_ptr<RDMResponse> response(GetResponseFromData(request.get()));
  unsigned int size = InvokeRDMHandler(request.get());
  EXPECT_THAT(ArrayTuple(g_rdm_buffer, size), ResponseIs(response.get()));

  interface_id = HostToNetwork(1);
  request = (BuildSetRequest(PID_INTERFACE_RELEASE_DHCP,
                             reinterpret_cast<uint8_t*>(&interface_id),
                             sizeof(interface_id)));
  response.reset(NackWithReason(request.get(),
                                ola::rdm::NR_ACTION_NOT_SUPPORTED));
  size = InvokeRDMHandler(request.get());
  EXPECT_THAT(ArrayTuple(g_rdm_buffer, size), ResponseIs(response.get()));
}

TEST_F(NetworkModelTest, defaultRoute) {
  // Set the default route
  const uint8_t param_data[] = {
    0x00, 0x00, 0x00, 0x00,
    0x0a, 0x0a, 0x1, 0x2
  };

  unique_ptr<RDMRequest> request = BuildSetRequest(
      PID_IPV4_DEFAULT_ROUTE, param_data, arraysize(param_data));

  unique_ptr<RDMResponse> response(GetResponseFromData(request.get()));

  int size = InvokeRDMHandler(request.get());
  EXPECT_THAT(ArrayTuple(g_rdm_buffer, size), ResponseIs(response.get()));

  // Read it back
  request = BuildGetRequest(PID_IPV4_DEFAULT_ROUTE);
  response.reset(GetResponseFromData(
        request.get(), param_data, arraysize(param_data)));

  size = InvokeRDMHandler(request.get());
  EXPECT_THAT(ArrayTuple(g_rdm_buffer, size), ResponseIs(response.get()));
}

TEST_F(NetworkModelTest, nameservers) {
  // Set the 2nd nameserver
  const uint8_t ip[] = {0x1, 0x0a, 0x0a, 0x1, 0x2};

  unique_ptr<RDMRequest> request = BuildSetRequest(
      PID_DNS_NAME_SERVER, ip, arraysize(ip));

  unique_ptr<RDMResponse> response(GetResponseFromData(request.get()));

  int size = InvokeRDMHandler(request.get());
  EXPECT_THAT(ArrayTuple(g_rdm_buffer, size), ResponseIs(response.get()));

  uint8_t index = 1;
  request = BuildGetRequest(PID_DNS_NAME_SERVER, &index, sizeof(uint8_t));
  response.reset(GetResponseFromData(request.get(), ip, arraysize(ip)));

  size = InvokeRDMHandler(request.get());
  EXPECT_THAT(ArrayTuple(g_rdm_buffer, size), ResponseIs(response.get()));

  // Check we get a NR_DATA_OUT_OF_RANGE
  index = 3;
  request = BuildGetRequest(PID_DNS_NAME_SERVER, &index, sizeof(uint8_t));
  response.reset(NackWithReason(request.get(), ola::rdm::NR_DATA_OUT_OF_RANGE));

  size = InvokeRDMHandler(request.get());
  EXPECT_THAT(ArrayTuple(g_rdm_buffer, size), ResponseIs(response.get()));
}

TEST_F(NetworkModelTest, hostname) {
  // Set the hostname
  const char hostname[] = "foo";
  unique_ptr<RDMRequest> request = BuildSetRequest(
      PID_DNS_HOSTNAME,
      reinterpret_cast<const uint8_t*>(hostname), strlen(hostname));

  unique_ptr<RDMResponse> response(GetResponseFromData(request.get()));

  int size = InvokeRDMHandler(request.get());
  EXPECT_THAT(ArrayTuple(g_rdm_buffer, size), ResponseIs(response.get()));

  // Read it back
  request = BuildGetRequest(PID_DNS_HOSTNAME);
  response.reset(GetResponseFromData(
        request.get(), reinterpret_cast<const uint8_t*>(hostname),
        strlen(hostname)));

  size = InvokeRDMHandler(request.get());
  EXPECT_THAT(ArrayTuple(g_rdm_buffer, size), ResponseIs(response.get()));
}

TEST_F(NetworkModelTest, domainName) {
  // Set the domain name
  const char domain_name[] = "myco.co.nz";
  unique_ptr<RDMRequest> request = BuildSetRequest(
      PID_DNS_DOMAIN_NAME,
      reinterpret_cast<const uint8_t*>(domain_name), strlen(domain_name));

  unique_ptr<RDMResponse> response(GetResponseFromData(request.get()));

  int size = InvokeRDMHandler(request.get());
  EXPECT_THAT(ArrayTuple(g_rdm_buffer, size), ResponseIs(response.get()));

  // Read it back
  request = BuildGetRequest(PID_DNS_DOMAIN_NAME);
  response.reset(GetResponseFromData(
        request.get(), reinterpret_cast<const uint8_t*>(domain_name),
        strlen(domain_name)));

  size = InvokeRDMHandler(request.get());
  EXPECT_THAT(ArrayTuple(g_rdm_buffer, size), ResponseIs(response.get()));
}
