OpenLightingProject/ja-rule/(commit log)

2015-01-03 Add the usb driver.
2015-01-03 Switch to using absolute paths so the project is portable across systems.
2015-01-03 Add the rest of the USB code, the device enumerates now.
2015-01-05 Add the basic framework for the App.
2015-01-13 Add the unit testing framework.
2015-01-16 Switch to working with older versions of autoconf, for Travis and others
2015-01-16 Use a #define to avoid the runtime function pointer, while still allowing us to inject a function for testing.
    [app.c]
2015-01-24 Fix a clang failure
    [stream_decoder.c]
2015-01-25 Fix some lint errors, add missing files.
    [FlagsTest.cpp, USBTransportTest.cpp, message_handler.c, message_handler.h]
2015-01-25 Try to fix the last of the lint errors.
    [USBTransportTest.cpp]
2015-02-09 Minor cleanup.
    s/Tx/TX/
    Add missing header files so we don't get weird linker behavior.
    [FlagsMock.cpp, FlagsMock.h, MessageHandlerMock.h, flags.c, flags.h, main.c, message_handler.c, message_handler.h]
2015-02-10 Fix the coverity defects.
    [Matchers.cpp, MessageHandlerMock.cpp, TransportMock.cpp]
2015-02-10 Moving embedded things into firmware folder to fix MHC problems
    [app.c, app.h, constants.h, flags.c, flags.h, flags_private.h, main.c, message.h]
2015-02-11 Add the CDC USB device and the system console.
2015-02-11 See if we can get a CDC device working.
2015-02-20 Add the Timer driver
2015-02-21 Remove the Driver Timer
2015-02-23 Basic DMX & RDM TX.
    Still plenty of things to fix:
    - Support RDM timeouts
    - Return the RDM responses to the host.
    - Make sure all the timing requirements are met
    - Move constants into a separate file
    - General code cleanup.
    [app.c, constants.h, message_handler.c, syslog.c]
2015-03-27 Add the rest of the testing framework.
2015-03-27 Add the missing files.
    [TransceiverTest.cpp, transceiver.c]
2015-04-02 Fix the build and a doxygen warning.
    [transceiver.c, transceiver.h]
2015-04-02 Add the coarse timer module.
2015-04-02 Disable interrupts when we fetch the timer value.
2015-04-02 Mark the timer variable as volitile.
2015-04-02 Add the missing symlink
    [coarse_timer.c]
2015-04-02 Use the new coarse timer module to ensure we don't violate the break to break timing.
2015-04-12 Clean up reset handling.
    [transceiver.c]
2015-04-12 Fix the newly discovered lint issues
    [app.c, message_handler.c, stream_decoder.c, transceiver.c]
2015-04-13 Fix the include guards
    [flags.h, flags_private.h, message.h, stream_decoder.h]
2015-04-13 Fix a bad merge.
    [transceiver.c]
2015-04-13 Fix the transceiver unittest.
    [TransceiverTest.cpp, transceiver.c]
2015-04-13 Fix a lint error.
    [transceiver.c]
2015-04-15 Update documentation & add a small test case.
2015-04-19 Fix a bug in handling broadcast requests.
    [MessageHandlerTest.cpp, message_handler.c]
2015-05-27 Handle the case where a very short low preceeds the break.
    [constants.h, transceiver.c]
2015-06-10 Re-apply the short-break fix.
    [transceiver.c]
2015-06-10 Fix the MPLAB build.
    [utils.h]
2015-06-13 Fix some bugs in the RDM Responder.
    Also add some more mocks.
    [RDMResponderTest.cpp, plib_usart_mock.cpp, plib_usart_mock.h, rdm.h, rdm_frame.h, rdm_responder.c, rdm_responder.h]
2015-06-14 Add the missing enums
    [transceiver.h]
2015-06-15 Fix a gcc warning.
    [rdm.h, rdm_responder.c, responder.c]
2015-06-16 Fix a coverity bug
    [ResponderTest.cpp, responder.c]
2015-06-18 RDM Responder improvements
    - Fix a mute / unmute bug
    - Fix all subdevice handling
    - Indicate identify / mute status with LEDs
    - Dump counters from the console
    [RDMResponderTest.cpp, app.c, message_handler.c, plib_ports.h, plib_ports_mock.cpp, plib_ports_mock.h, rdm_responder.c, rdm_responder.h]
2015-06-18 Fix the build again
    [message_handler.c]
2015-06-18 Add the pin assignments for the reference design.
2015-06-19 Add the missing transceiver.c changes.
    [transceiver.c]
2015-06-19 Fix a lint warning
    [transceiver.c]
2015-07-11 Use static where appropriate to avoid exporting functions.
    [message_handler.c, responder.c, stream_decoder.c]
2015-07-11 Add a responder jitter option.
    [MessageHandlerTest.cpp, TransceiverMock.cpp, TransceiverMock.h, TransceiverTest.cpp, constants.h, message_handler.c, transceiver.c, transceiver.h]
2015-07-11 Switch to clang-3.7
2015-07-12 Move the inter-slot constants to the correct file.
    [transceiver.c, transceiver_timing.h]
2015-07-13 Add jitter to the RDM response times.
    [app.c, random.c, random.h, transceiver.c]
2015-07-13 Fix the response delay, clean up docs.
    [transceiver.c]
2015-07-13 Add a command to fetch the UID of the device.
2015-07-14 Add the SPI RGB code
2015-07-14 Add the ResponderTest for SPI
2015-07-14 Add missing files, fix lint
    [SPIRGBMock.cpp, SPIRGBMock.h, spi_rgb.c]
2015-07-15 Add the missing include
    [spi_rgb.c]
2015-07-17 Fix lint & doxygen.
    [rdm_handler.c, rdm_handler.h]
2015-07-17 Fix a enum name.
    [rdm.h, rdm_buffer.c, rdm_buffer.h]
2015-07-17 Try to fix the includes again
    [rdm_responder.c, rdm_responder.h]
2015-07-17 Switch to using RDMHandler as the entry point for RDM responders.
2015-07-17 Fix comments & fix the build
    [rdm_handler.h, rdm_model.h, responder.c]
2015-07-17 Fix a bug in the RDMHandler.
    [rdm_handler.c]
2015-07-17 Fix the clang build
    [RDMHandlerTest.cpp]
2015-07-17 Address comments & fix some bugs
    [Matchers.h, RDMHandlerTest.cpp, rdm_handler.c, rdm_responder.c, rdm_responder.h]
2015-07-18 Fix comments and lint
    [RDMResponderTest.cpp, rdm.h, rdm_responder.c]
2015-07-18 Switch back to using SPI, add more tests
2015-07-18 Fix a bug, 100% on the responder tests now.
    [rdm_responder.c]
2015-07-20 Add the model_id_list PID
2015-07-21 Add the missing files
    [app.c, rdm.h, rdm_responder.c, rdm_responder.h]
2015-07-21 Add the sensor model
2015-07-21 Sample sensor data every second
2015-07-22 Add slot information messages
2015-07-23 Add the network device to the docs.
2015-07-24 Initial commit of the sub device dimmer model
2015-07-24 Fix a lint error
    [network_model.c]
2015-07-24 Fixes for the network responder.
    [network_model.c, rdm.h]
2015-07-29 More cleanup based on MISRA style guide.
    https://en.wikipedia.org/wiki/Motor_Industry_Software_Reliability_Association
2015-07-29 Use the mute & identify leds for all models.
    Previously this only worked with the simple model, which wasn't very useful.
2015-07-31 Add comments & honor sub-device reporting thresholds
2015-07-31 Add Reset, clock & language pids to the moving light.
    [app.c, moving_light.c, rdm.h]
2015-07-31 Add the barebones proxy model.
    Discovery is working. The next step is to ACK TIMER responses from the child
    devices and use queued messages to get the actual RDM response.
2015-07-31 Fix the tests, add FACTORY_DEFAULTS
    [Matchers.h, ResponderTest.cpp, app.c, moving_light.c, rdm_responder.c, rdm_responder.h, receiver_counters.c, receiver_counters.h]
2015-07-31 Fix lint & build
    [receiver_counters.h]
2015-08-02 Add the pixel count & pixel type PIDs.
    These don't do anything yet, but later they'll affect how the SPI data is used.
    This also adds support for PARAMETER_DESCRIPTION, the last of the PLASA PIDs.
2015-08-02 Use a method to switch responder rather than changing the pointer directly.
2015-08-02 Fix a todo in the proxy code.
    [proxy_model.c]
2015-08-06 Add the bootloader stub.
    This correctly enumerates as a DFU device.
    [app.c, app.h, constants.h, main.c]
2015-08-06 Switch to polled mode USB
2015-08-08 Convert dos line endings to unix.
    Also add a simple blinking LED so I can tell when the bootloader is running
    while I'm testing.
2015-08-27 Don't track coverage on the tests themselves
2015-08-27 Split the USB descriptors into a separate file.
    This allows us to create board specific hardware configs without duplicating
    all the USB data.
2015-08-28 Minor cleanup to fix a warning.
    [app.c, rdm.h]
2015-08-29 Add the number8 board configuration.
2015-09-05 Add board specific hooks, flash all leds during bootloader mode
2015-09-05 Fix a bug in the bootloader
    [bootloader.c]
2015-09-06 Add the initial hardware designs
    [number1.SchDoc]
2015-09-07 Set the USB power consumption correct.
    [system_settings.h]
2015-09-07 Move the number1 design to a directory
    [number1.SchDoc]
2015-09-07 Move board config to it's own directory.
2015-09-08 Fix a bunch of lint warnings
    [bootloader_usb_descriptors.c, flash.c]
2015-09-13 Fix the licence enforcer warnings
    [app_settings.h]
2015-09-17 Add the configuration for the Number1 board
2015-09-17 Switch to the new gmock
2015-09-19 Correctly return INVALID_MODE when we're in RX mode
    [message_handler.c]
2015-09-26 Add checks to ensure people don't load the wrong f/w onto devices.
    [BootloaderTransferTest.cpp, bootloader.c]
2015-10-05 New board config options.
    This adds options for:
    - using the MAC address to derive the UID
    - disabling flashing the UID using DFU.
    It also cleans up a lot of the documentation.
2015-10-06 Add the config options & update all the board configs
2015-10-11 Fix some Coverity issues
    [Matchers.cpp, MessageHandlerMock.cpp]
2015-10-11 Port the main app to Harmony 1.06.
    This also fixes a bug in reset.c
    [app.c]
2015-10-11 Add the temperature sensor, only available on Number1 for now.
2015-10-11 Fix a bug in the initialization of the sensor responder.
    [sensor_model.c]
2015-10-12 RDM Responder changes.
    - Only flash the Identify & Mute leds when we're in responder mode
    - Correctly reset the control field flags when we switch models.
    [app.c, dimmer_model.c, led_model.c, moving_light.c, network_model.c, proxy_model.c, rdm_responder.c, rdm_responder.h]
2015-10-14 Add a self test command.
    This puts the driver circuit into loopback mode, sends a single byte, then
    verifies we received it. That way we can check that the 485 driver is working.
    Side note: using separate control lines for TX / RX Enable just paid off!!
2015-10-16 Recalibrate the temperature sensor every 5 minutes
2015-10-25 Fix a bug in the RX code.
    This is why we need tests! Coming soon in a PR near you.
    [transceiver.c]
2015-10-30 Switch from auto_ptr to unique_ptr
2015-11-04 Add a README, fix coverity bug
    [PeripheralUART.cpp]
2015-11-04 Add a jumbo frame responder RX test
2015-11-10 Add a response time fudge factor.
    The ISR runs about 1.5us after the UART event. Experiments point to 13 as the
    best value. From my tests we're accurate to within 0.2 of a microsecond from
    the value recorded with the Logic.
2015-11-13 Add the SPI driver.
2015-11-13 Fix the build, add another test
    [SPITest.cpp, spi.h]
2015-11-14 SPI improvements
2016-02-17 Add the standalone Stellascapes Number1 PID file
2016-02-17 Add some instructions for how to add the additional PID data file
2016-03-01 Switch to Steve's OLA repo
2016-03-07 Fix some minor lint issues
    [ModelTest.h, transceiver_timing.h]
2016-09-07 Switch to unique_ptr
2016-09-07 Switch to gcc-6
2016-11-13 Switch Coverity to the C compiler, it ill find the C++ one
2017-01-09 Temporarily switch to my key
2017-01-11 Use the correct event tag for Coverity
    As per https://scan.coverity.com/models#codeannotate
    [random.c]
2017-11-10 Switch to clang-5.0
2018-02-22 Correct a documentation typo
    [constants.h]
2018-02-26 Fix some codespell errors
    [BootloaderTestHelper.cpp, LauncherMock.cpp, PeripheralTimer.cpp, PeripheralUART.h, rdm_responder.h, transceiver.h]
2018-05-29 Fix a load more codespell errror
    [app_settings.h, dimmer_model.c, rdm_util.h, transceiver.c, transceiver.h]
2018-05-29 Fix more spelling mistakes
    [bootloader.c, bootloader_usb_descriptors.c, flags.h, rdm.h, transport.h]
2018-06-02 Switch to clang 6 given we've upgraded to Trusty
